hsetlik/ESP808_mk3/Schematic/Design/BoardImg.png

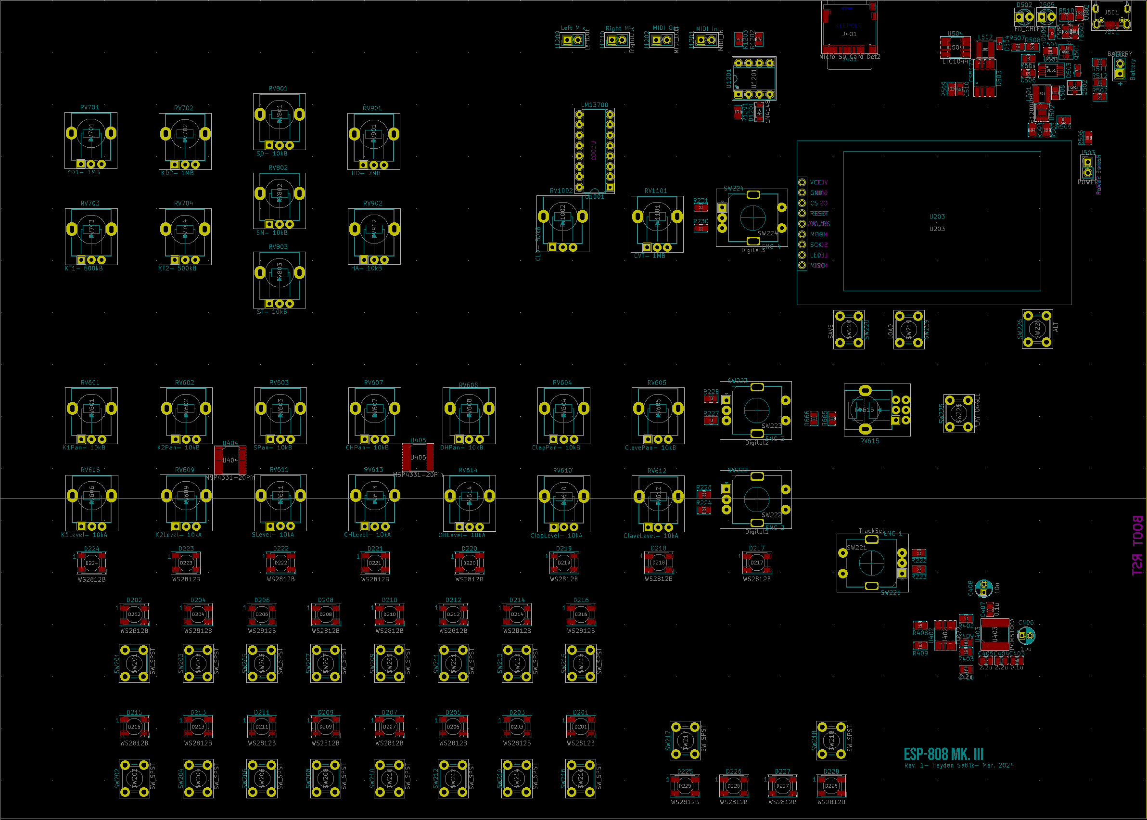
Schematic/Design/BoardImg.png
