hsetlik/ESP808_mk3/Schematic/Analog.kicad_sch

## KiCad design Schematic/Analog.kicad_sch (2024-04-10)

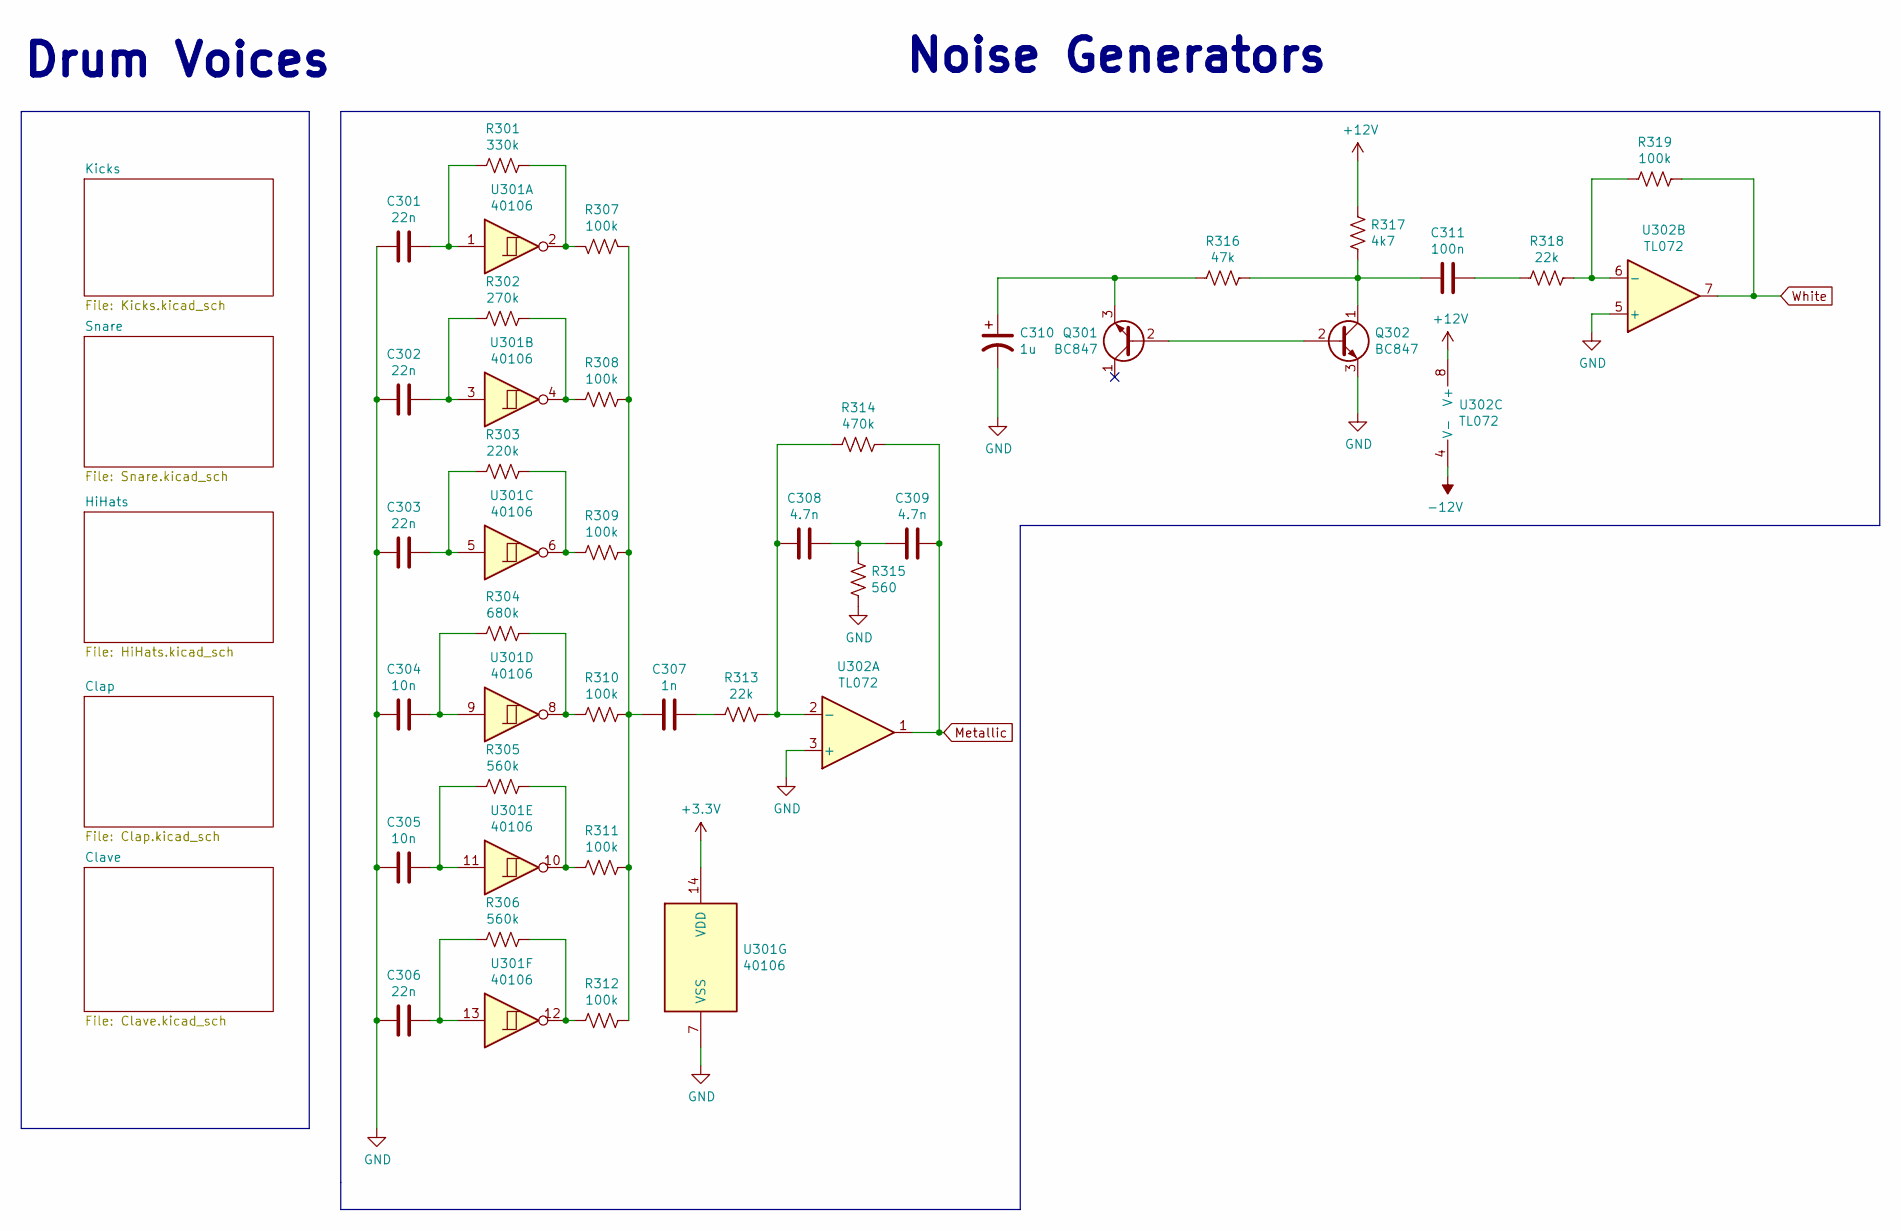
[picture p2: schematic Analog.kicad_sch]

Parts:
C301, C302, C303, C306: 22n; C_0805_2012Metric
C304, C305: 10n; C_0805_2012Metric
C307: 1n; C_0805_2012Metric
C308, C309: 4.7n; C_0805_2012Metric
C310: 1u; CP_Radial_D4.0mm_P2.00mm
C311: 100n; C_0805_2012Metric
Q301, Q302: BC847; SOT-23
R301: 330k; R_0805_2012Metric
R302: 270k; R_0805_2012Metric
R303: 220k; R_0805_2012Metric
R304: 680k; R_0805_2012Metric
R305, R306: 560k; R_0805_2012Metric
R307, R308, R309, R310, R311, R312, R319: 100k; R_0805_2012Metric
R313, R318: 22k; R_0805_2012Metric
R314: 470k; R_0805_2012Metric
R315: 560; R_0805_2012Metric
R316: 47k; R_0805_2012Metric
R317: 4k7; R_0805_2012Metric
U301: 40106; SOIC-14_3.9x8.7mm_P1.27mm
U302: TL072; SOIC-8_3.9x4.9mm_P1.27mm

Connections:
+3.3V: U301.14 (VDD)
+12V: R317.2, U302.8 (V+)
-12V: U302.4 (V-)
GND: C301.2, C302.2, C303.2, C304.2, C305.2, C306.2, C310.2, Q302.3 (E), R315.1, U301.7 (VSS), U302.3 (+), U302.5 (+)
Metallic: C309.1, R314.2, U302.1
unnamed: C301.1, R301.2, U301.1
unnamed: C302.1, R302.2, U301.3
unnamed: C303.1, R303.2, U301.5
unnamed: C304.1, R304.2, U301.9
unnamed: C305.1, R305.2, U301.11
unnamed: C306.1, R306.2, U301.13
unnamed: C307.1, R313.2
unnamed: C307.2, R307.1, R308.1, R309.1, R310.1, R311.1, R312.1
unnamed: C308.1, C309.2, R315.2
unnamed: C308.2, R313.1, R314.1, U302.2 (-)
unnamed: C310.1, Q301.3 (E), R316.2
unnamed: C311.1, R318.2
unnamed: C311.2, Q302.1 (C), R316.1, R317.1
unnamed: Q301.2 (B), Q302.2 (B)
unnamed: R301.1, R307.2, U301.2
unnamed: R302.1, R308.2, U301.4
unnamed: R303.1, R309.2, U301.6
unnamed: R304.1, R310.2, U301.8
unnamed: R305.1, R311.2, U301.10
unnamed: R306.1, R312.2, U301.12
unnamed: R318.1, R319.2, U302.6 (-)
White: R319.1, U302.7

Notes on the sheet:
Drum Voices
Noise Generators
