hsetlik/ESP808_mk3/Schematic/Clap.kicad_sch

## KiCad design Schematic/Clap.kicad_sch (2024-04-10)

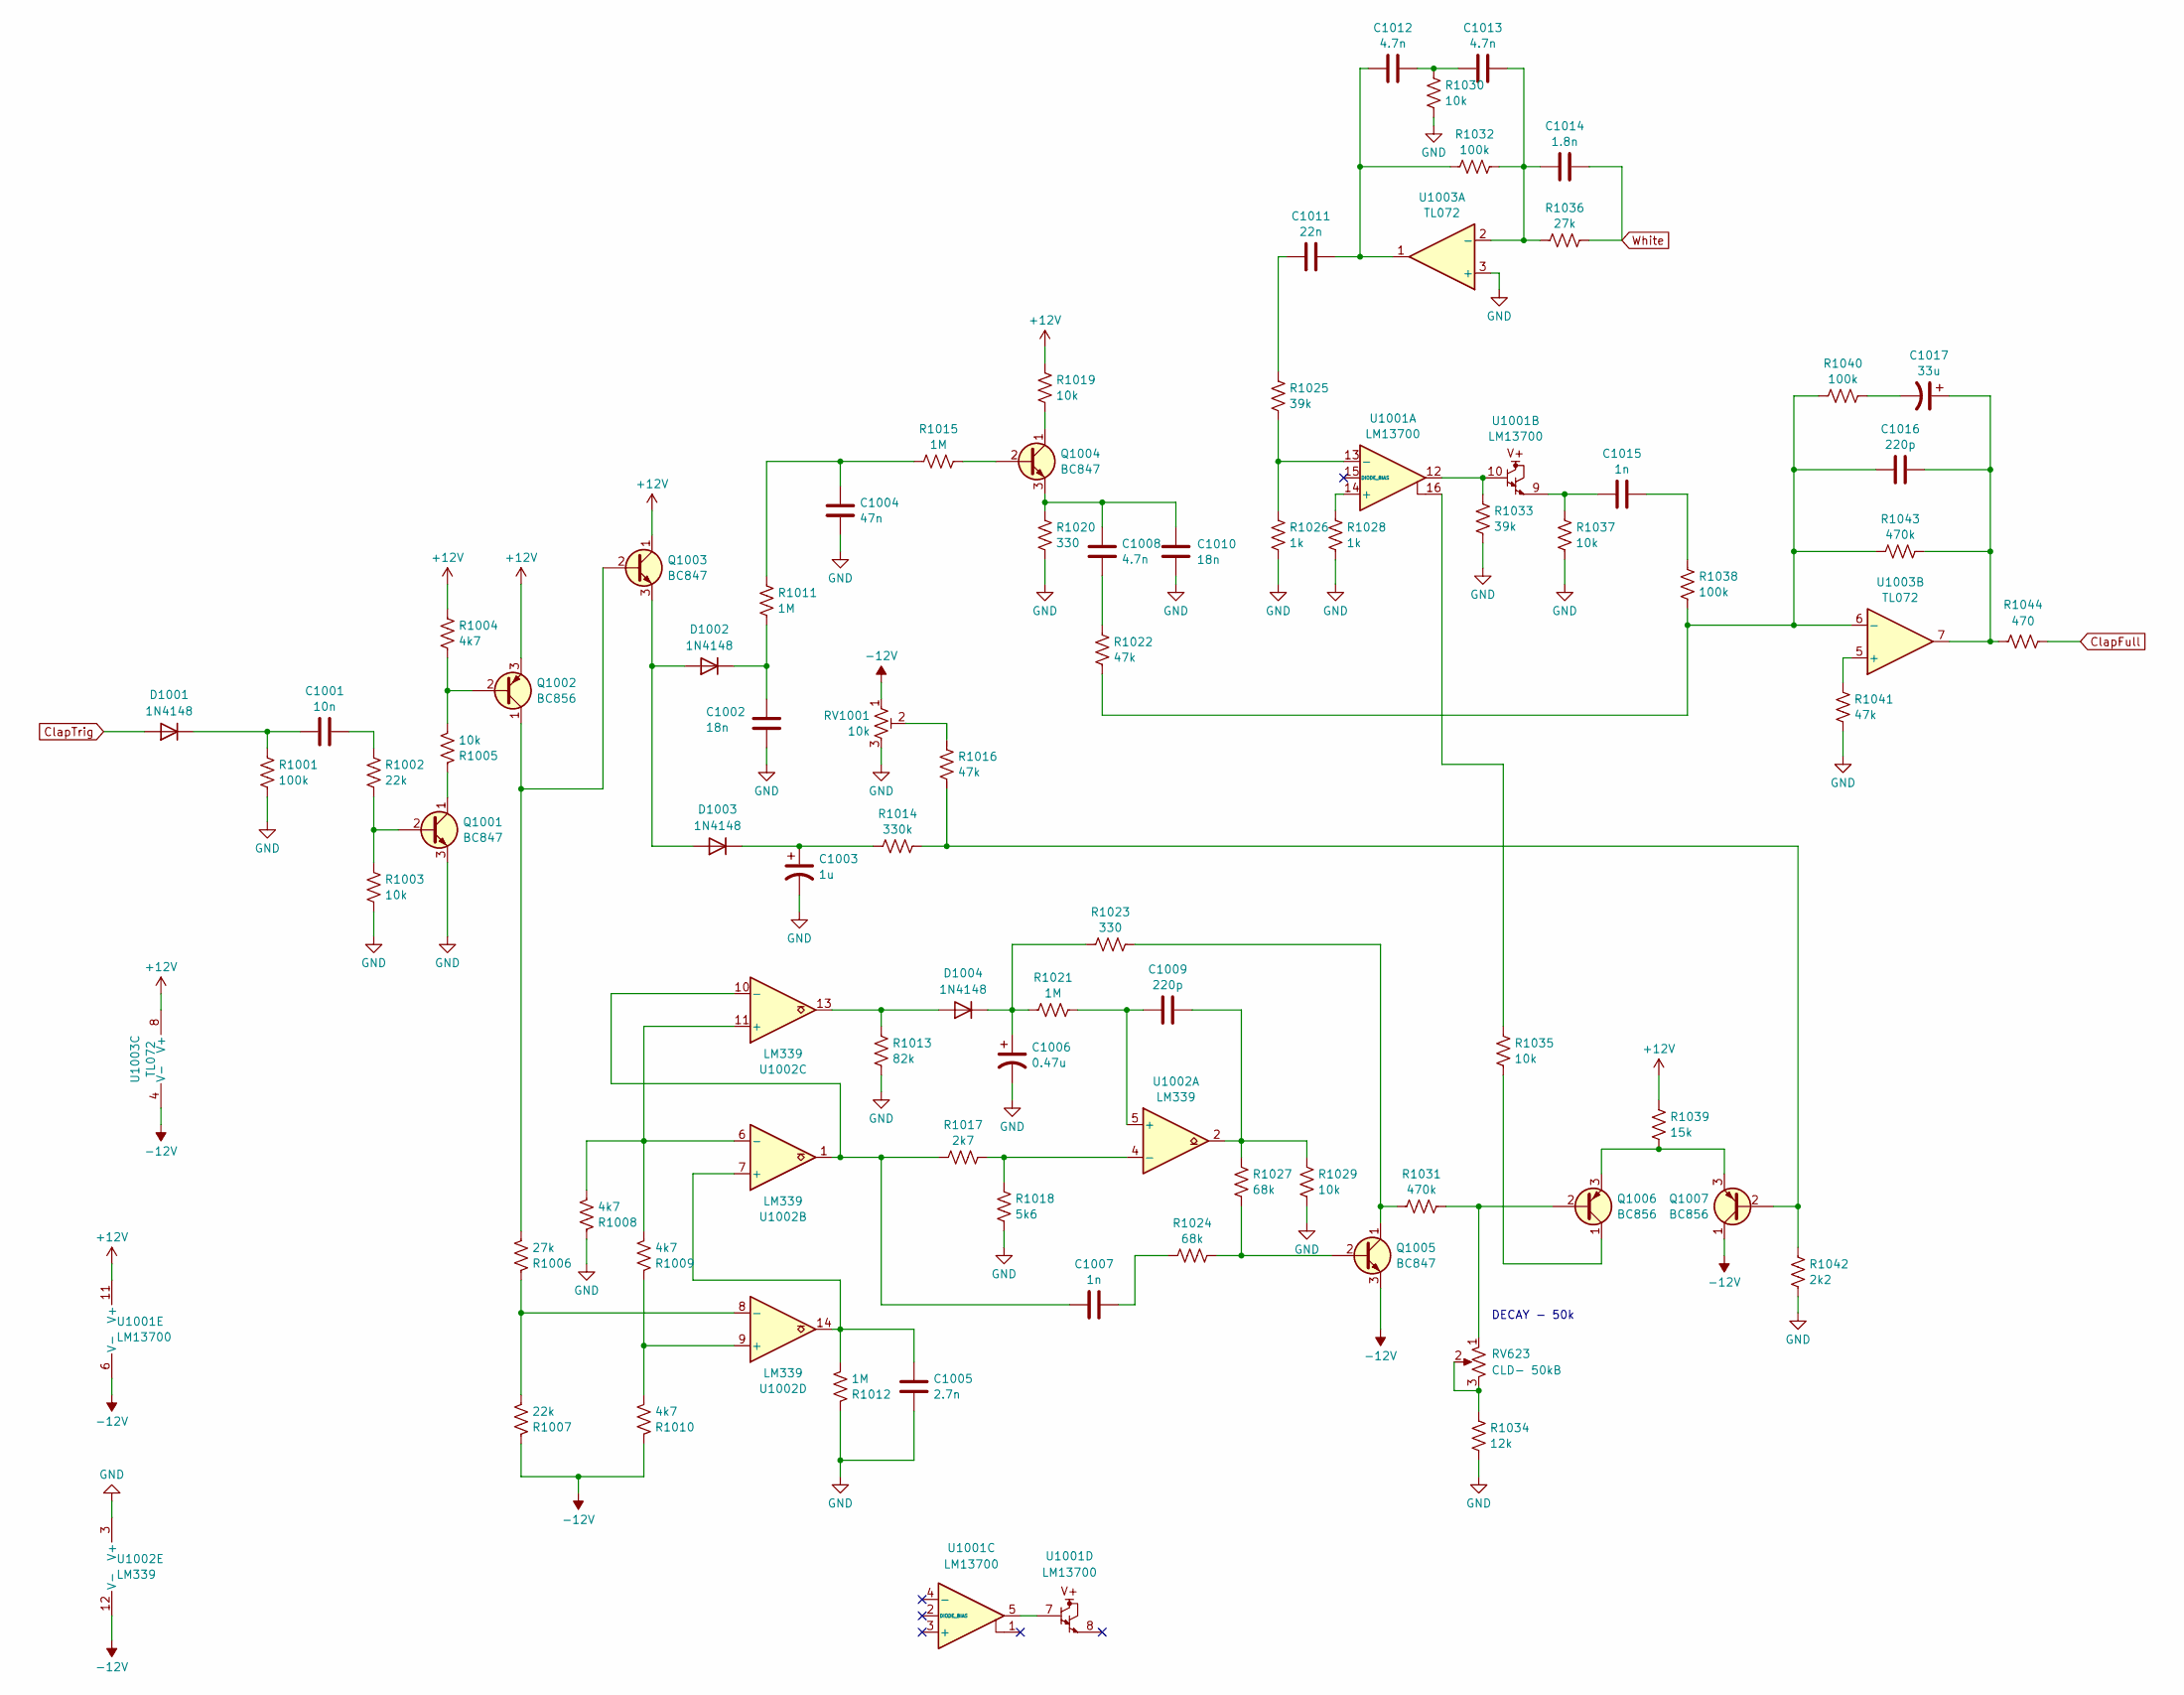
[picture p3: schematic Clap.kicad_sch]

Parts:
C1001: 10n; C_0805_2012Metric
C1002, C1010: 18n; C_0805_2012Metric
C1003: 1u; CP_Radial_D4.0mm_P2.00mm
C1004: 47n; C_0805_2012Metric
C1005: 2.7n; C_0805_2012Metric
C1006: 0.47u; C_0805_2012Metric
C1007, C1015: 1n; C_0805_2012Metric
C1008, C1012, C1013: 4.7n; C_0805_2012Metric
C1009, C1016: 220p; C_0805_2012Metric
C1011: 22n; C_0805_2012Metric
C1014: 1.8n; C_0805_2012Metric
C1017: 33u; CP_Radial_D5.0mm_P2.00mm
D1001, D1002, D1003, D1004: 1N4148; D_SOD-123
Q1001, Q1003, Q1004, Q1005: BC847; SOT-23
Q1002, Q1006, Q1007: BC856; SOT-23
R1001, R1032, R1038, R1040: 100k; R_0805_2012Metric
R1002, R1007: 22k; R_0805_2012Metric
R1003, R1005, R1019, R1029, R1030, R1035, R1037: 10k; R_0805_2012Metric
R1004, R1008, R1009, R1010: 4k7; R_0805_2012Metric
R1006, R1036: 27k; R_0805_2012Metric
R1011, R1012, R1015, R1021: 1M; R_0805_2012Metric
R1013: 82k; R_0805_2012Metric
R1014: 330k; R_0805_2012Metric
R1016, R1022, R1041: 47k; R_0805_2012Metric
R1017: 2k7; R_0805_2012Metric
R1018: 5k6; R_0805_2012Metric
R1020, R1023: 330; R_0805_2012Metric
R1024, R1027: 68k; R_0805_2012Metric
R1025, R1033: 39k; R_0805_2012Metric
R1026, R1028: 1k; R_0805_2012Metric
R1031, R1043: 470k; R_0805_2012Metric
R1034: 12k; R_0805_2012Metric
R1039: 15k; R_0805_2012Metric
R1042: 2k2; R_0805_2012Metric
R1044: 470; R_0805_2012Metric
RV623: CLD- 50kB; Potentiometer_Alpha_RD901F-40-00D_Single_Vertical
RV1001: 10k; Potentiometer_Piher_PT-6-V_Vertical
U1001: LM13700; DIP-16_W7.62mm
U1002: LM339; SOIC-14_3.9x8.7mm_P1.27mm
U1003: TL072; SOIC-8_3.9x4.9mm_P1.27mm

Connections:
+12V: Q1002.3 (E), Q1003.1 (C), R1004.1, R1019.1, R1039.2, U1001.11 (V+), U1003.8 (V+)
-12V: Q1005.3 (E), Q1007.1 (C), R1007.1, R1010.1, RV1001.1, U1001.6 (V-), U1002.12 (V-), U1003.4 (V-)
ClapFull: R1044.2
ClapTrig: D1001.2 (A)
GND: C1002.2, C1003.2, C1004.2, C1005.2, C1006.2, C1010.2, Q1001.3 (E), R1001.2, R1003.2, R1008.1, R1012.1, R1013.1, R1018.1, R1020.2, R1026.2, R1028.2, R1029.1, R1030.2, R1033.2, R1034.1, R1037.2, R1041.2, R1042.1, RV1001.3, U1002.3 (V+), U1003.3 (+)
unnamed: C1001.1, D1001.1 (K), R1001.1
unnamed: C1001.2, R1002.1
unnamed: C1002.1, D1002.1 (K), R1011.2
unnamed: C1003.1, D1003.1 (K), R1014.1
unnamed: C1004.1, R1011.1, R1015.1
unnamed: C1005.1, R1012.2, U1002.7 (+), U1002.14
unnamed: C1006.1, D1004.1 (K), R1021.2, R1023.2
unnamed: C1007.1, R1024.2
unnamed: C1007.2, R1017.1, U1002.1, U1002.10 (-)
unnamed: C1008.1, C1010.1, Q1004.3 (E), R1020.1
unnamed: C1008.2, R1022.1
unnamed: C1009.1, R1027.2, R1029.2, U1002.2
unnamed: C1009.2, R1021.1, U1002.5 (+)
unnamed: C1011.1, R1025.1
unnamed: C1011.2, C1012.1, R1032.1, U1003.1
unnamed: C1012.2, C1013.1, R1030.1
unnamed: C1013.2, C1014.1, R1032.2, R1036.1, U1003.2 (-)
unnamed: C1015.1, R1037.1, U1001.9
unnamed: C1015.2, R1038.1
unnamed: C1016.1, R1022.2, R1038.2, R1040.1, R1043.1, U1003.6 (-)
unnamed: C1016.2, C1017.1, R1043.2, R1044.1, U1003.7
unnamed: C1017.2, R1040.2
unnamed: D1002.2 (A), D1003.2 (A), Q1003.3 (E)
unnamed: D1004.2 (A), R1013.2, U1002.13
unnamed: Q1001.1 (C), R1005.1
unnamed: Q1001.2 (B), R1002.2, R1003.1
unnamed: Q1002.1 (C), Q1003.2 (B), R1006.2
unnamed: Q1002.2 (B), R1004.2, R1005.2
unnamed: Q1004.1 (C), R1019.2
unnamed: Q1004.2 (B), R1015.2
unnamed: Q1005.1 (C), R1023.1, R1031.2
unnamed: Q1005.2 (B), R1024.1, R1027.1
unnamed: Q1006.1 (C), R1035.2
unnamed: Q1006.2 (B), R1031.1, RV623.1
unnamed: Q1006.3 (E), Q1007.3 (E), R1039.1
unnamed: Q1007.2 (B), R1014.2, R1016.2, R1042.2
unnamed: R1006.1, R1007.2, U1002.8 (-)
unnamed: R1008.2, R1009.2, U1002.6 (-), U1002.11 (+)
unnamed: R1009.1, R1010.2, U1002.9 (+)
unnamed: R1016.1, RV1001.2
unnamed: R1017.2, R1018.2, U1002.4 (-)
unnamed: R1025.2, R1026.1, U1001.13 (-)
unnamed: R1028.1, U1001.14 (+)
unnamed: R1033.1, U1001.10, U1001.12
unnamed: R1034.2, RV623.2, RV623.3
unnamed: R1035.1, U1001.16
unnamed: R1041.1, U1003.5 (+)
unnamed: U1001.5, U1001.7
White: C1014.2, R1036.2

Notes on the sheet:
DECAY - 50k
