hsetlik/ESP808_mk3/Schematic/Clave.kicad_sch

## KiCad design Schematic/Clave.kicad_sch (2024-04-11)

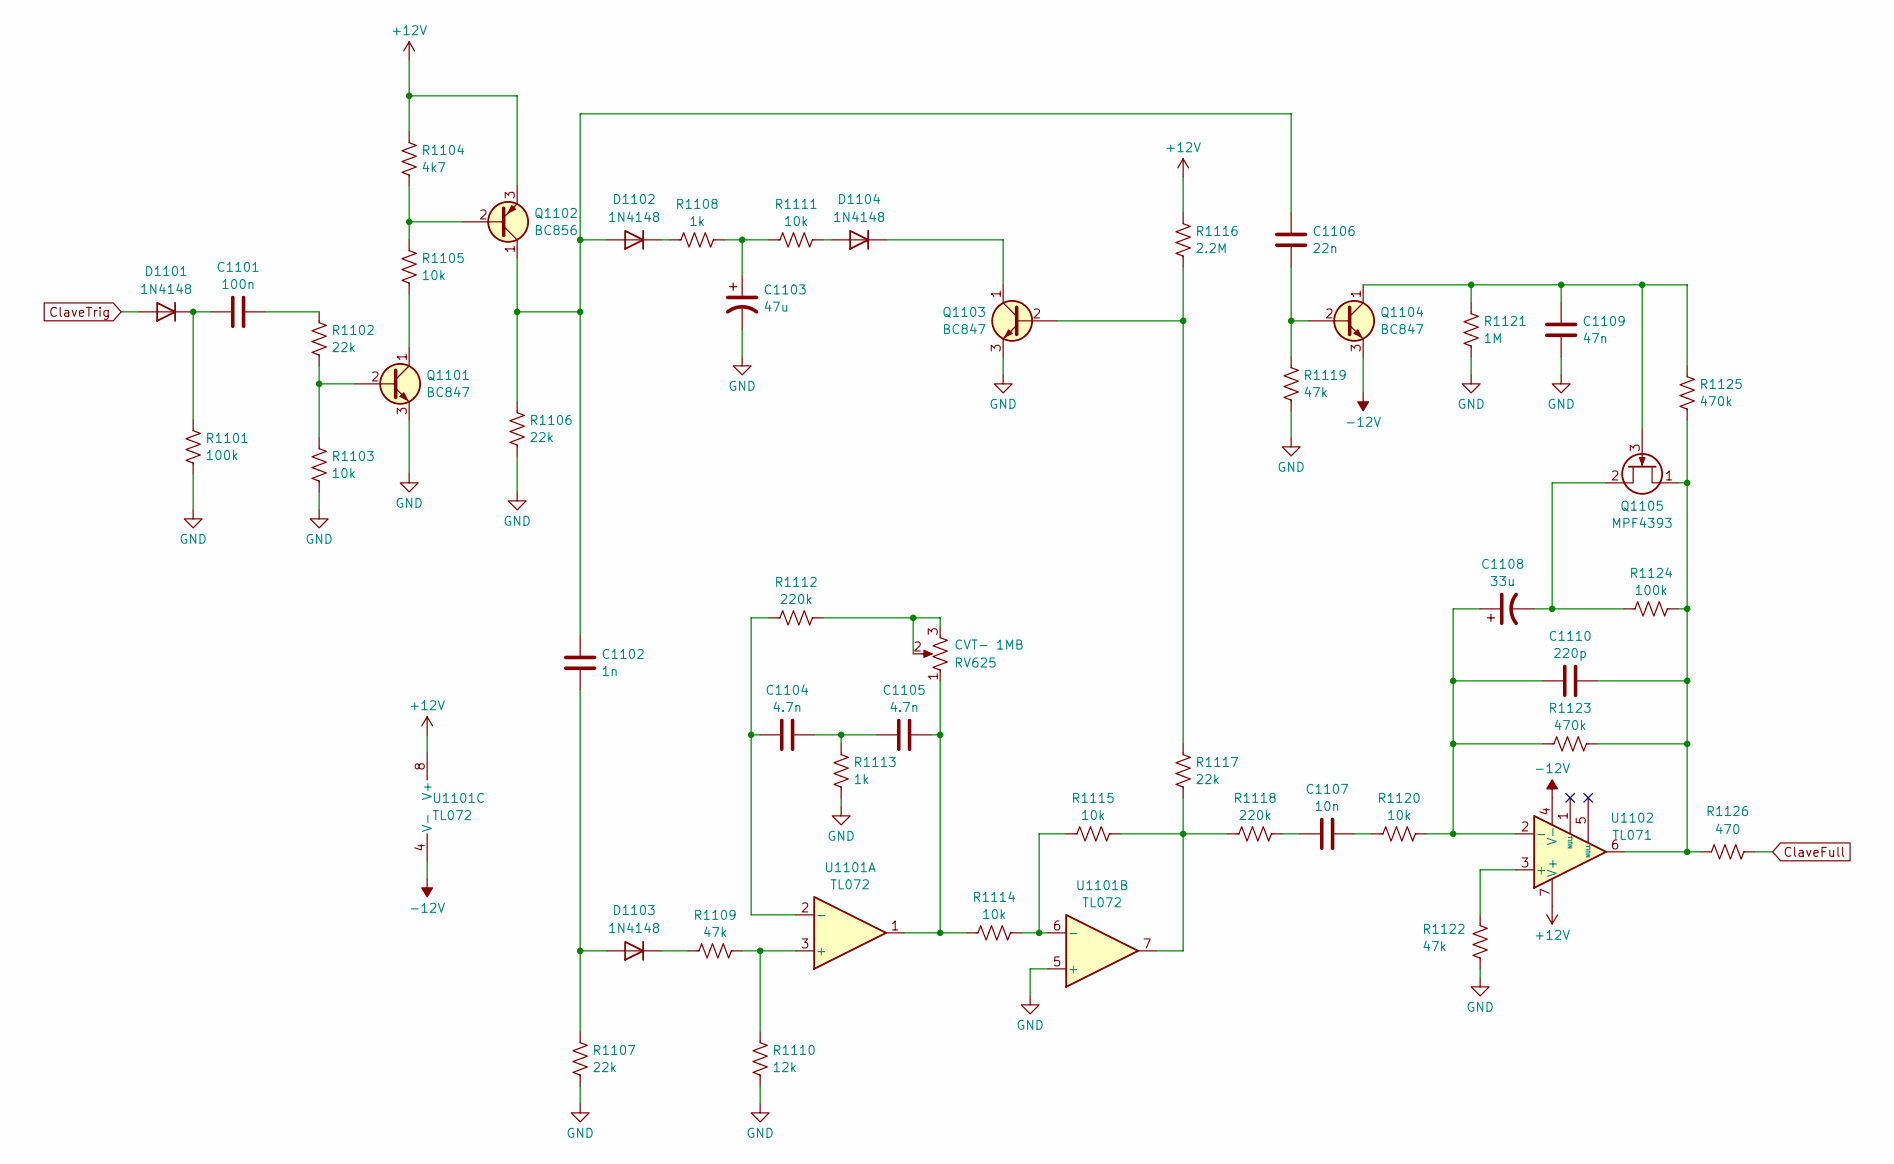
[picture p4: schematic Clave.kicad_sch]

Parts:
C1101: 100n; C_0805_2012Metric
C1102: 1n; C_0805_2012Metric
C1103: 47u; CP_Radial_D5.0mm_P2.00mm
C1104, C1105: 4.7n; C_0805_2012Metric
C1106: 22n; C_0805_2012Metric
C1107: 10n; C_0805_2012Metric
C1108: 33u; CP_Radial_D5.0mm_P2.00mm
C1109: 47n; C_0805_2012Metric
C1110: 220p; C_0805_2012Metric
D1101, D1102, D1103, D1104: 1N4148; D_SOD-123
Q1101, Q1103, Q1104: BC847; SOT-23
Q1102: BC856; SOT-23
Q1105: MPF4393; TO-92L
R1101, R1124: 100k; R_0805_2012Metric
R1102, R1106, R1107, R1117: 22k; R_0805_2012Metric
R1103, R1105, R1111, R1114, R1115, R1120: 10k; R_0805_2012Metric
R1104: 4k7; R_0805_2012Metric
R1108, R1113: 1k; R_0805_2012Metric
R1109, R1119, R1122: 47k; R_0805_2012Metric
R1110: 12k; R_0805_2012Metric
R1112, R1118: 220k; R_0805_2012Metric
R1116: 2.2M; R_0805_2012Metric
R1121: 1M; R_0805_2012Metric
R1123, R1125: 470k; R_0805_2012Metric
R1126: 470; R_0805_2012Metric
RV625: CVT- 1MB; Potentiometer_Alpha_RD901F-40-00D_Single_Vertical
U1101: TL072; SOIC-8_3.9x4.9mm_P1.27mm
U1102: TL071; SOIC-8_3.9x4.9mm_P1.27mm

Connections:
+12V: Q1102.3 (E), R1104.1, R1116.2, U1101.8 (V+), U1102.7 (V+)
-12V: Q1104.3 (E), U1101.4 (V-), U1102.4 (V-)
ClaveFull: R1126.2
ClaveTrig: D1101.2 (A)
GND: C1103.2, C1109.2, Q1101.3 (E), Q1103.3 (E), R1101.2, R1103.2, R1106.2, R1107.1, R1110.1, R1113.2, R1119.1, R1121.2, R1122.1, U1101.5 (+)
unnamed: C1101.1, D1101.1 (K), R1101.1
unnamed: C1101.2, R1102.1
unnamed: C1102.1, C1106.1, D1102.2 (A), Q1102.1 (C), R1106.1
unnamed: C1102.2, D1103.2 (A), R1107.2
unnamed: C1103.1, R1108.2, R1111.1
unnamed: C1104.1, R1112.1, U1101.2 (-)
unnamed: C1104.2, C1105.1, R1113.1
unnamed: C1105.2, R1114.1, RV625.1, U1101.1
unnamed: C1106.2, Q1104.2 (B), R1119.2
unnamed: C1107.1, R1118.2
unnamed: C1107.2, R1120.1
unnamed: C1108.1, C1110.1, R1120.2, R1123.1, U1102.2 (-)
unnamed: C1108.2, Q1105.2 (S), R1124.1
unnamed: C1109.1, Q1104.1 (C), Q1105.3 (G), R1121.1, R1125.1
unnamed: C1110.2, Q1105.1 (D), R1123.2, R1124.2, R1125.2, R1126.1, U1102.6
unnamed: D1102.1 (K), R1108.1
unnamed: D1103.1 (K), R1109.2
unnamed: D1104.1 (K), Q1103.1 (C)
unnamed: D1104.2 (A), R1111.2
unnamed: Q1101.1 (C), R1105.2
unnamed: Q1101.2 (B), R1102.2, R1103.1
unnamed: Q1102.2 (B), R1104.2, R1105.1
unnamed: Q1103.2 (B), R1116.1, R1117.2
unnamed: R1109.1, R1110.2, U1101.3 (+)
unnamed: R1112.2, RV625.2, RV625.3
unnamed: R1114.2, R1115.1, U1101.6 (-)
unnamed: R1115.2, R1117.1, R1118.1, U1101.7
unnamed: R1122.2, U1102.3 (+)
