hsetlik/ESP808_mk3/Schematic/Controls.kicad_sch

## KiCad design Schematic/Controls.kicad_sch (2024-04-14)

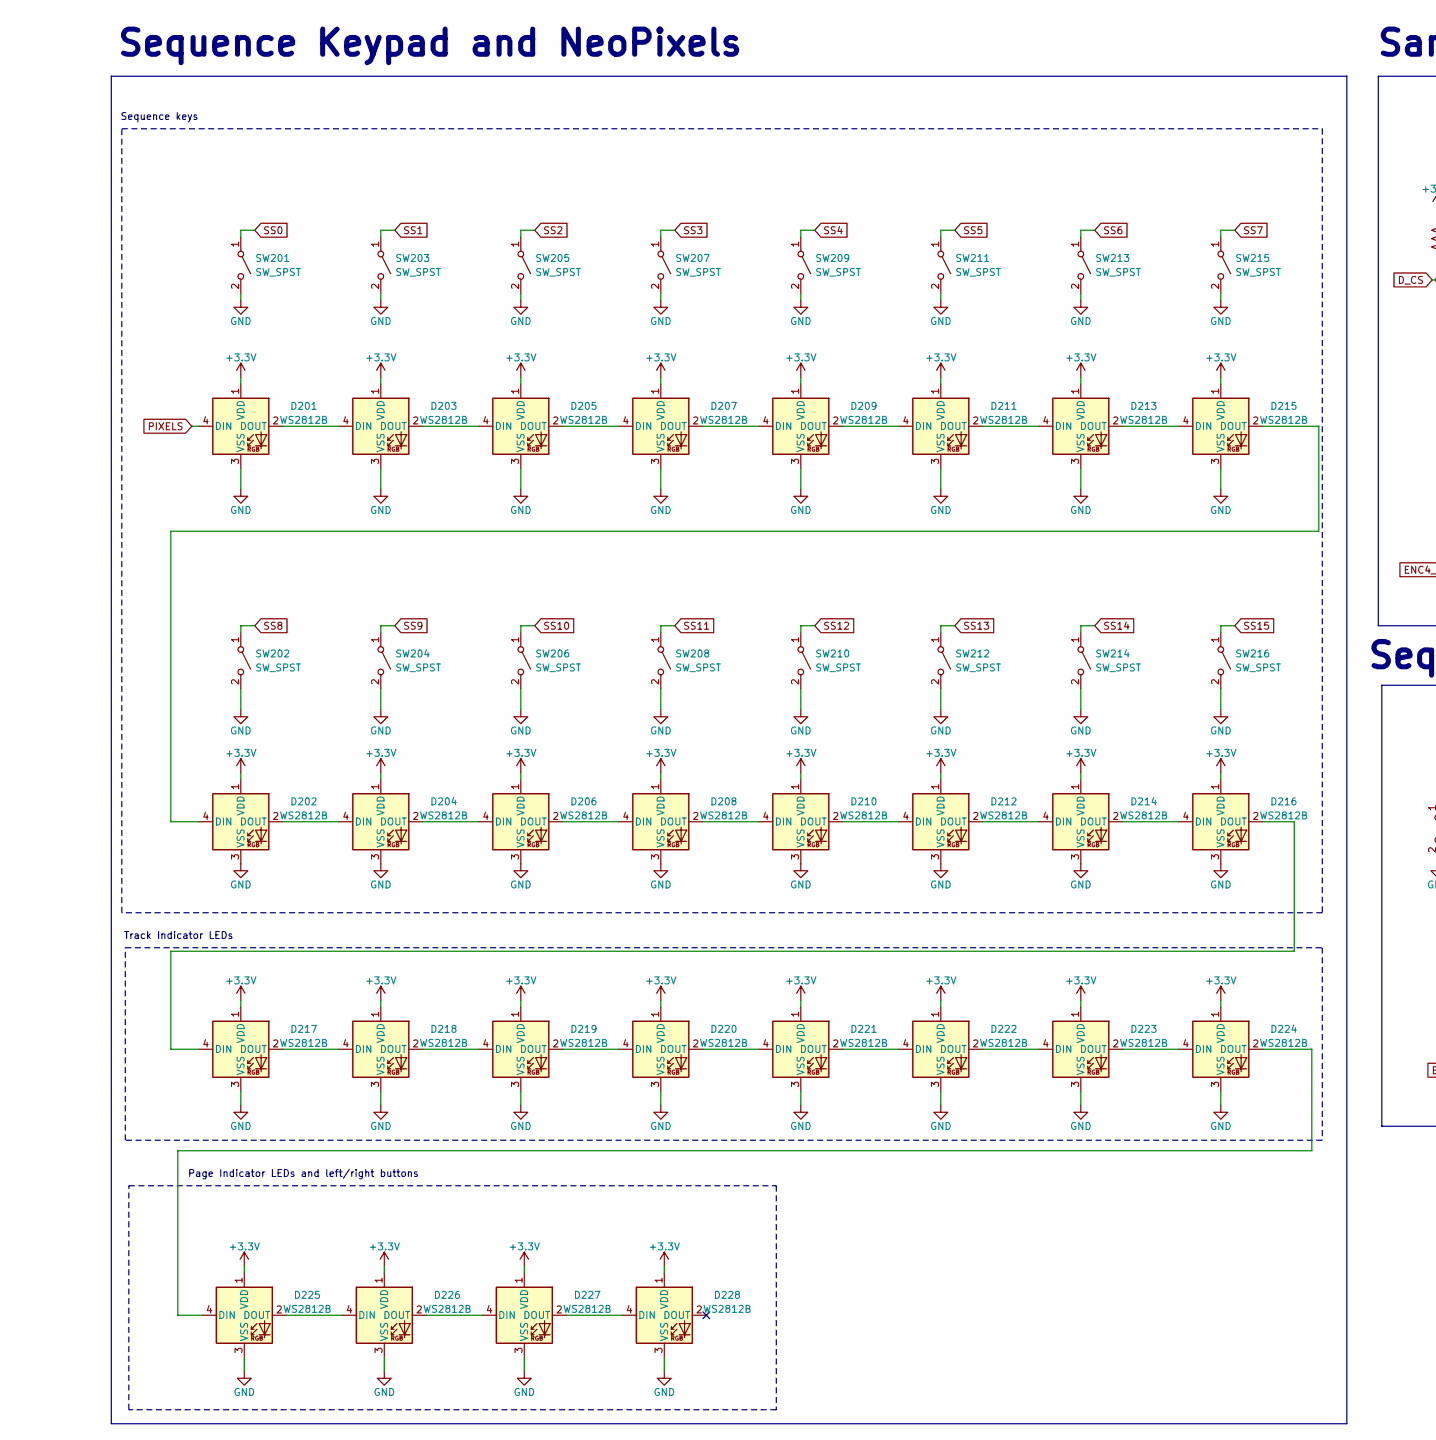
[picture p5: schematic Controls.kicad_sch, part in row 1, column 1]

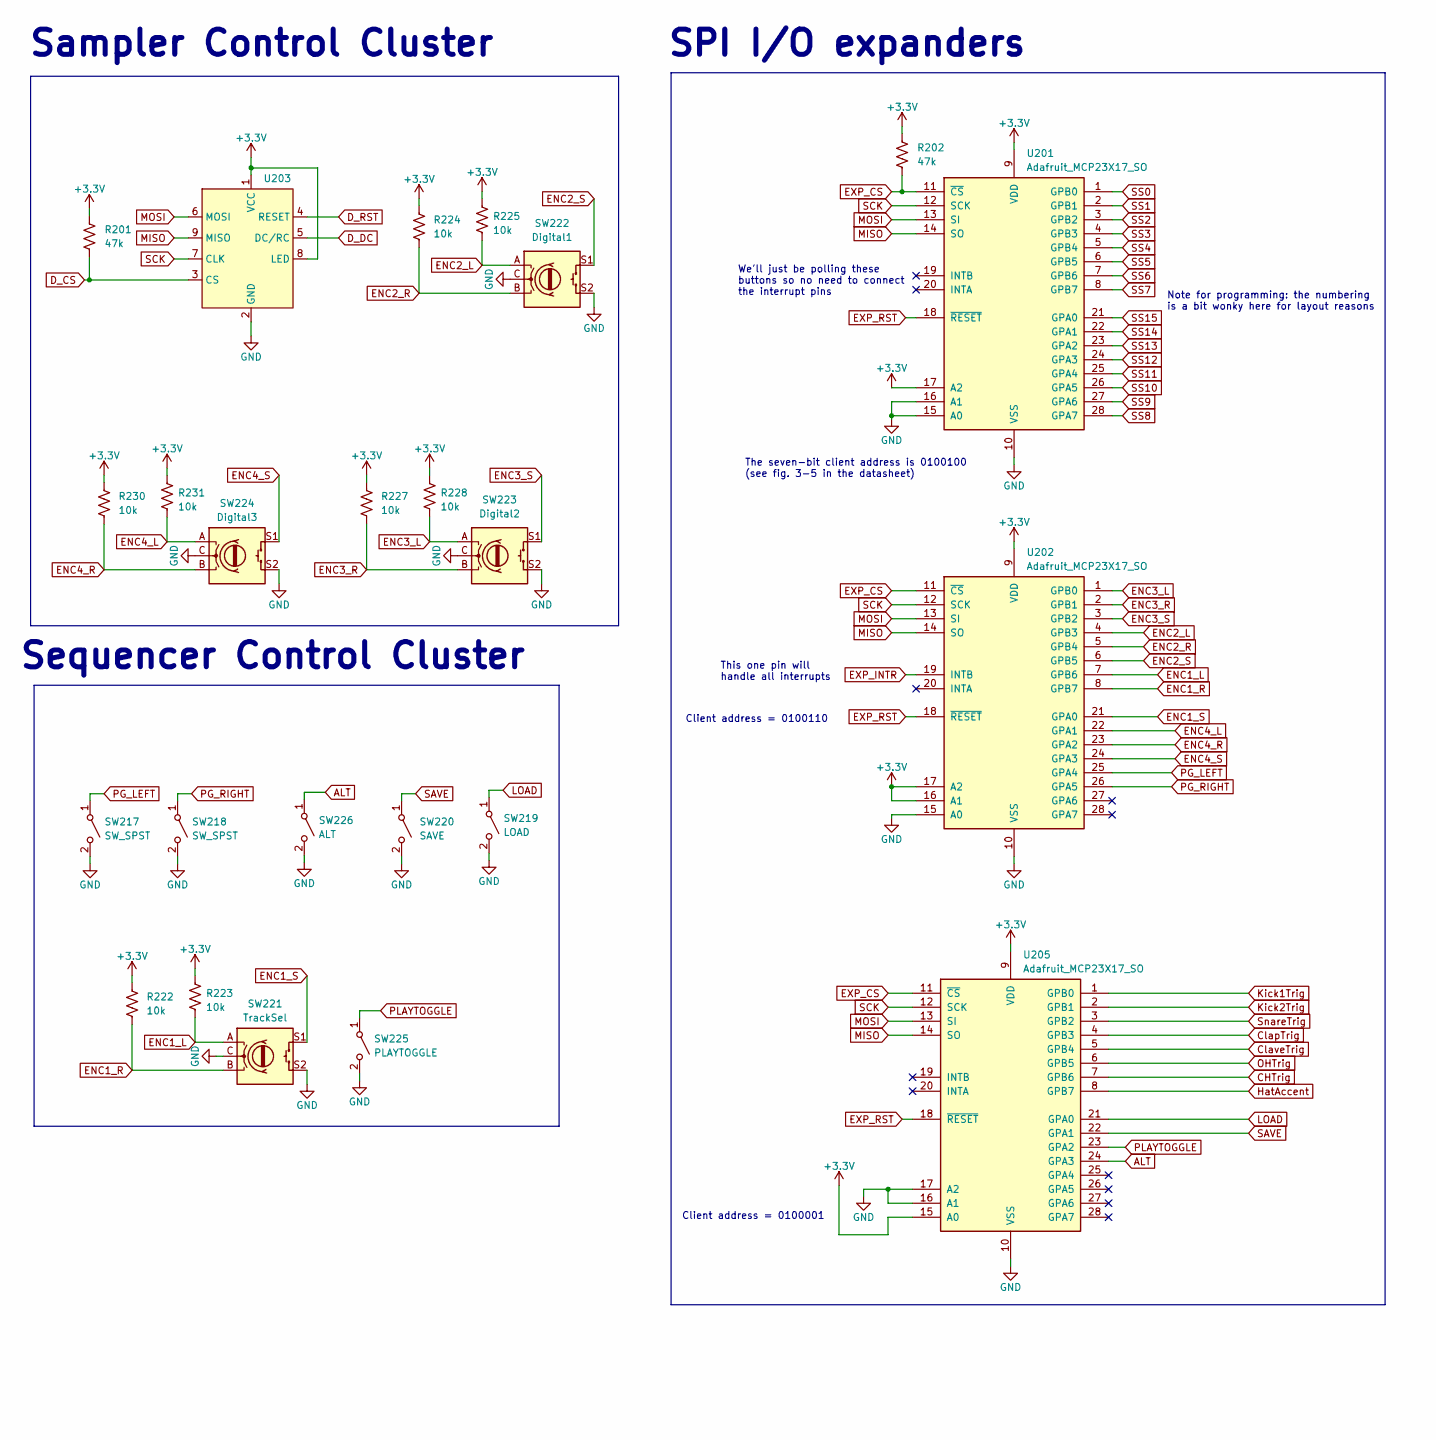
[picture p6: schematic Controls.kicad_sch, part in row 1, column 2]

Parts:
D201, D202, D203, D204, D205, D206, D207, D208, D209, D210, D211, D212, D213, D214, D215, D216, D217, D218, D219, D220, D221, D222, D223, D224, D225, D226, D227, D228: WS2812B; LED_WS2812B_PLCC4_5.0x5.0mm_P3.2mm
R201, R202: 47k; R_0805_2012Metric
R222, R223, R224, R225, R227, R228, R230, R231: 10k; R_0805_2012Metric
SW201, SW202, SW203, SW204, SW205, SW206, SW207, SW208, SW209, SW210, SW211, SW212, SW213, SW214, SW215, SW216, SW217, SW218: SW_SPST; SW_PUSH_6mm
SW219: LOAD; SW_PUSH_6mm
SW220: SAVE; SW_PUSH_6mm
SW221: TrackSel; RotaryEncoder_Alps_EC11E-Switch_Vertical_H20mm_5Pin
SW222: Digital1; RotaryEncoder_Alps_EC11E-Switch_Vertical_H20mm_5Pin
SW223: Digital2; RotaryEncoder_Alps_EC11E-Switch_Vertical_H20mm_5Pin
SW224: Digital3; RotaryEncoder_Alps_EC11E-Switch_Vertical_H20mm_5Pin
SW225: PLAYTOGGLE; SW_PUSH_6mm
SW226: ALT; SW_PUSH_6mm
U201, U202, U205: Adafruit_MCP23X17_SO; SOIC-28W_7.5x17.9mm_P1.27mm
U203: TFTBreakout_ILI9341_340x320

Connections:
+3.3V: D201.1 (VDD), D202.1 (VDD), D203.1 (VDD), D204.1 (VDD), D205.1 (VDD), D206.1 (VDD), D207.1 (VDD), D208.1 (VDD), D209.1 (VDD), D210.1 (VDD), D211.1 (VDD), D212.1 (VDD), D213.1 (VDD), D214.1 (VDD), D215.1 (VDD), D216.1 (VDD), D217.1 (VDD), D218.1 (VDD), D219.1 (VDD), D220.1 (VDD), D221.1 (VDD), D222.1 (VDD), D223.1 (VDD), D224.1 (VDD), D225.1 (VDD), D226.1 (VDD), D227.1 (VDD), D228.1 (VDD), R201.1, R202.1, R222.1, R223.1, R224.1, R225.1, R227.1, R228.1, R230.1, R231.1, U201.9 (VDD), U201.17 (A2), U202.9 (VDD), U202.16 (A1), U202.17 (A2), U203.1 (VCC), U203.8 (LED), U205.9 (VDD), U205.15 (A0)
ALT: SW226.1 (A), U205.24 (GPA3)
CHTrig: U205.7 (GPB6)
ClapTrig: U205.4 (GPB3)
ClaveTrig: U205.5 (GPB4)
D_CS: R201.2, U203.3 (CS)
D_DC: U203.5 (DC/RC)
D_RST: U203.4 (RESET)
ENC1_L: R223.2, SW221.A, U202.7 (GPB6)
ENC1_R: R222.2, SW221.B, U202.8 (GPB7)
ENC1_S: SW221.S1, U202.21 (GPA0)
ENC2_L: R225.2, SW222.A, U202.4 (GPB3)
ENC2_R: R224.2, SW222.B, U202.5 (GPB4)
ENC2_S: SW222.S1, U202.6 (GPB5)
ENC3_L: R228.2, SW223.A, U202.1 (GPB0)
ENC3_R: R227.2, SW223.B, U202.2 (GPB1)
ENC3_S: SW223.S1, U202.3 (GPB2)
ENC4_L: R231.2, SW224.A, U202.22 (GPA1)
ENC4_R: R230.2, SW224.B, U202.23 (GPA2)
ENC4_S: SW224.S1, U202.24 (GPA3)
EXP_CS: R202.2, U201.11 (~CS), U202.11 (~CS), U205.11 (~CS)
EXP_INTR: U202.19 (INTB)
EXP_RST: U201.18 (~RESET), U202.18 (~RESET), U205.18 (~RESET)
GND: D201.3 (VSS), D202.3 (VSS), D203.3 (VSS), D204.3 (VSS), D205.3 (VSS), D206.3 (VSS), D207.3 (VSS), D208.3 (VSS), D209.3 (VSS), D210.3 (VSS), D211.3 (VSS), D212.3 (VSS), D213.3 (VSS), D214.3 (VSS), D215.3 (VSS), D216.3 (VSS), D217.3 (VSS), D218.3 (VSS), D219.3 (VSS), D220.3 (VSS), D221.3 (VSS), D222.3 (VSS), D223.3 (VSS), D224.3 (VSS), D225.3 (VSS), D226.3 (VSS), D227.3 (VSS), D228.3 (VSS), SW201.2 (B), SW202.2 (B), SW203.2 (B), SW204.2 (B), SW205.2 (B), SW206.2 (B), SW207.2 (B), SW208.2 (B), SW209.2 (B), SW210.2 (B), SW211.2 (B), SW212.2 (B), SW213.2 (B), SW214.2 (B), SW215.2 (B), SW216.2 (B), SW217.2 (B), SW218.2 (B), SW219.2 (B), SW220.2 (B), SW221.C, SW221.S2, SW222.C, SW222.S2, SW223.C, SW223.S2, SW224.C, SW224.S2, SW225.2 (B), SW226.2 (B), U201.10 (VSS), U201.15 (A0), U201.16 (A1), U202.10 (VSS), U202.15 (A0), U203.2 (GND), U205.10 (VSS), U205.16 (A1), U205.17 (A2)
HatAccent: U205.8 (GPB7)
Kick1Trig: U205.1 (GPB0)
Kick2Trig: U205.2 (GPB1)
LOAD: SW219.1 (A), U205.21 (GPA0)
MISO: U201.14 (SO), U202.14 (SO), U203.9 (MISO), U205.14 (SO)
MOSI: U201.13 (SI), U202.13 (SI), U203.6 (MOSI), U205.13 (SI)
unnamed: D201.2 (DOUT), D203.4 (DIN)
unnamed: D202.2 (DOUT), D204.4 (DIN)
unnamed: D202.4 (DIN), D215.2 (DOUT)
unnamed: D203.2 (DOUT), D205.4 (DIN)
unnamed: D204.2 (DOUT), D206.4 (DIN)
unnamed: D205.2 (DOUT), D207.4 (DIN)
unnamed: D206.2 (DOUT), D208.4 (DIN)
unnamed: D207.2 (DOUT), D209.4 (DIN)
unnamed: D208.2 (DOUT), D210.4 (DIN)
unnamed: D209.2 (DOUT), D211.4 (DIN)
unnamed: D210.2 (DOUT), D212.4 (DIN)
unnamed: D211.2 (DOUT), D213.4 (DIN)
unnamed: D212.2 (DOUT), D214.4 (DIN)
unnamed: D213.2 (DOUT), D215.4 (DIN)
unnamed: D214.2 (DOUT), D216.4 (DIN)
unnamed: D216.2 (DOUT), D217.4 (DIN)
unnamed: D217.2 (DOUT), D218.4 (DIN)
unnamed: D218.2 (DOUT), D219.4 (DIN)
unnamed: D219.2 (DOUT), D220.4 (DIN)
unnamed: D220.2 (DOUT), D221.4 (DIN)
unnamed: D221.2 (DOUT), D222.4 (DIN)
unnamed: D222.2 (DOUT), D223.4 (DIN)
unnamed: D223.2 (DOUT), D224.4 (DIN)
unnamed: D224.2 (DOUT), D225.4 (DIN)
unnamed: D225.2 (DOUT), D226.4 (DIN)
unnamed: D226.2 (DOUT), D227.4 (DIN)
unnamed: D227.2 (DOUT), D228.4 (DIN)
OHTrig: U205.6 (GPB5)
PG_LEFT: SW217.1 (A), U202.25 (GPA4)
PG_RIGHT: SW218.1 (A), U202.26 (GPA5)
PIXELS: D201.4 (DIN)
PLAYTOGGLE: SW225.1 (A), U205.23 (GPA2)
SAVE: SW220.1 (A), U205.22 (GPA1)
SCK: U201.12 (SCK), U202.12 (SCK), U203.7 (CLK), U205.12 (SCK)
SS0: SW201.1 (A), U201.1 (GPB0)
SS1: SW203.1 (A), U201.2 (GPB1)
SS2: SW205.1 (A), U201.3 (GPB2)
SS3: SW207.1 (A), U201.4 (GPB3)
SS4: SW209.1 (A), U201.5 (GPB4)
SS5: SW211.1 (A), U201.6 (GPB5)
SS6: SW213.1 (A), U201.7 (GPB6)
SS7: SW215.1 (A), U201.8 (GPB7)
SS8: SW202.1 (A), U201.28 (GPA7)
SS9: SW204.1 (A), U201.27 (GPA6)
SS10: SW206.1 (A), U201.26 (GPA5)
SS11: SW208.1 (A), U201.25 (GPA4)
SS12: SW210.1 (A), U201.24 (GPA3)
SS13: SW212.1 (A), U201.23 (GPA2)
SS14: SW214.1 (A), U201.22 (GPA1)
SS15: SW216.1 (A), U201.21 (GPA0)
SnareTrig: U205.3 (GPB2)

Notes on the sheet:
Sequencer Control Cluster
Client address = 0100001
Sampler Control Cluster
This one pin will handle all interrupts
Sequence Keypad and NeoPixels
SPI I/O expanders
Sequence keys
Page Indicator LEDs and left/right buttons
We'll just be polling these buttons so no need to connect the interrupt pins
Track Indicator LEDs
Note for programming: the numbering is a bit wonky here for layout reasons
Client address = 0100110
The seven-bit client address is 0100100 (see fig. 3-5 in the datasheet)
