hsetlik/ESP808_mk3/Schematic/HiHats.kicad_sch

## KiCad design Schematic/HiHats.kicad_sch (2024-04-10)

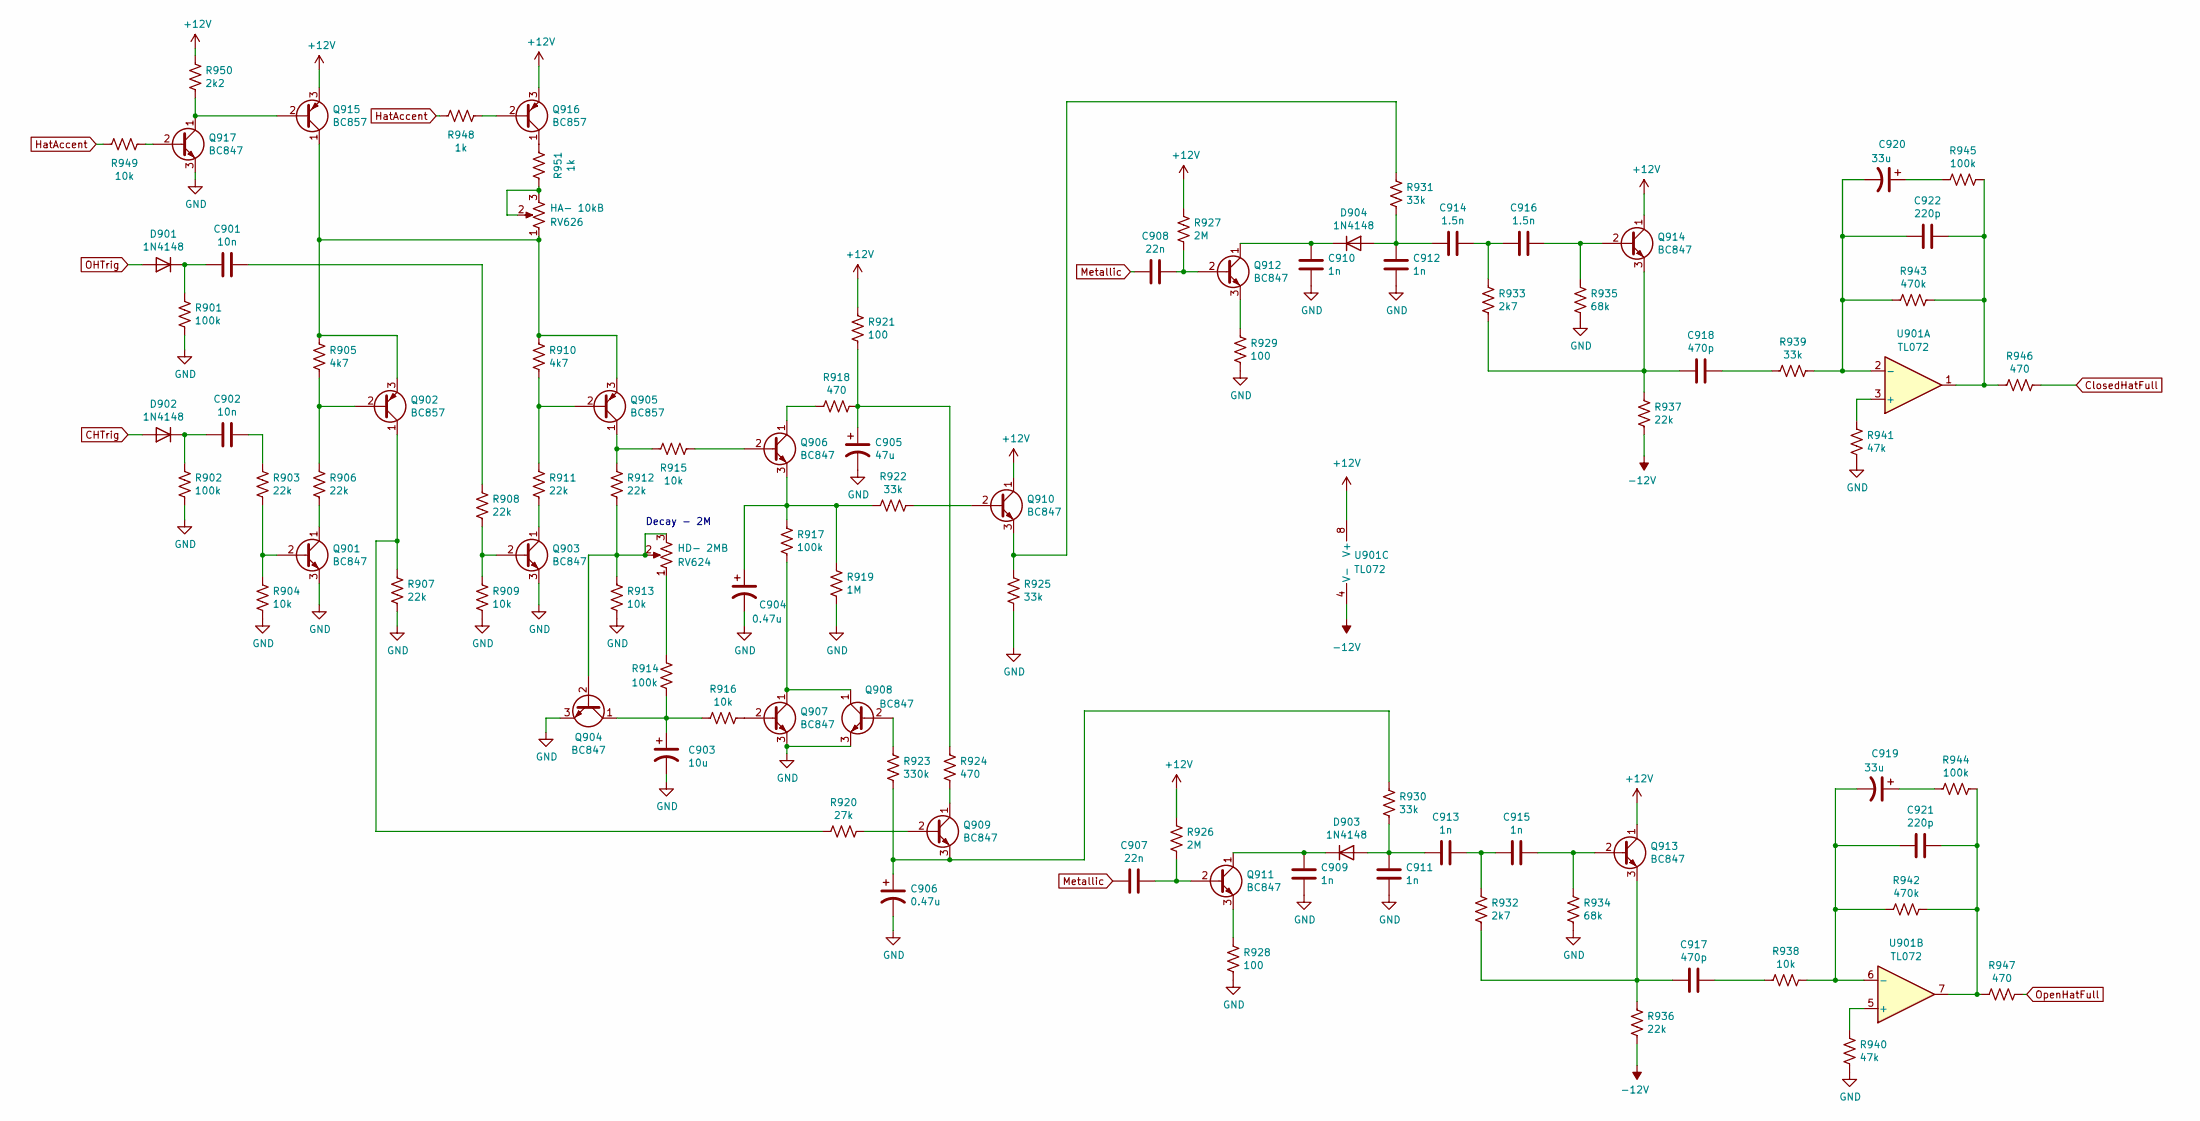
[picture p7: schematic HiHats.kicad_sch]

Parts:
C901, C902: 10n; C_0805_2012Metric
C903: 10u; CP_Radial_D4.0mm_P2.00mm
C904, C906: 0.47u; CP_Radial_D4.0mm_P2.00mm
C905: 47u; CP_Radial_D4.0mm_P2.00mm
C907, C908: 22n; C_0805_2012Metric
C909, C910, C911, C912, C913, C915: 1n; C_0805_2012Metric
C914, C916: 1.5n; C_0805_2012Metric
C917, C918: 470p; C_0805_2012Metric
C919, C920: 33u; CP_Radial_D5.0mm_P2.00mm
C921, C922: 220p; C_0805_2012Metric
D901, D902, D903, D904: 1N4148; D_SOD-123
Q901, Q903, Q904, Q906, Q907, Q908, Q909, Q910, Q911, Q912, Q913, Q914, Q917: BC847; SOT-23
Q902, Q905, Q915, Q916: BC857; SOT-23
R901, R902, R914, R917, R944, R945: 100k; R_0805_2012Metric
R903, R906, R907, R908, R911, R912, R936, R937: 22k; R_0805_2012Metric
R904, R909, R913, R915, R916, R938, R949: 10k; R_0805_2012Metric
R905, R910: 4k7; R_0805_2012Metric
R918, R924, R946, R947: 470; R_0805_2012Metric
R919: 1M; R_0805_2012Metric
R920: 27k; R_0805_2012Metric
R921, R928, R929: 100; R_0805_2012Metric
R922, R925, R930, R931, R939: 33k; R_0805_2012Metric
R923: 330k; R_0805_2012Metric
R926, R927: 2M; R_0805_2012Metric
R932, R933: 2k7; R_0805_2012Metric
R934, R935: 68k; R_0805_2012Metric
R940, R941: 47k; R_0805_2012Metric
R942, R943: 470k; R_0805_2012Metric
R948, R951: 1k; R_0805_2012Metric
R950: 2k2; R_0805_2012Metric
RV624: HD- 2MB; Potentiometer_Alpha_RD901F-40-00D_Single_Vertical
RV626: HA- 10kB; Potentiometer_Alpha_RD901F-40-00D_Single_Vertical
U901: TL072; SOIC-8_3.9x4.9mm_P1.27mm

Connections:
+12V: Q910.1 (C), Q913.1 (C), Q914.1 (C), Q915.3 (E), Q916.3 (E), R921.2, R926.1, R927.1, R950.1, U901.8 (V+)
-12V: R936.2, R937.2, U901.4 (V-)
CHTrig: D902.2 (A)
ClosedHatFull: R946.1
GND: C903.2, C904.2, C905.2, C906.2, C909.1, C910.1, C911.1, C912.1, Q901.3 (E), Q903.3 (E), Q904.3 (E), Q907.3 (E), Q908.3 (E), Q917.3 (E), R901.2, R902.2, R904.2, R907.2, R909.2, R913.2, R919.2, R925.1, R928.2, R929.2, R934.2, R935.2, R940.1, R941.1
HatAccent: R948.2, R949.2
Metallic: C907.2, C908.2
unnamed: C901.1, R908.1
unnamed: C901.2, D901.1 (K), R901.1
unnamed: C902.1, R903.1
unnamed: C902.2, D902.1 (K), R902.1
unnamed: C903.1, Q904.1 (C), R914.2, R916.2
unnamed: C904.1, Q906.3 (E), R917.1, R919.1, R922.2
unnamed: C905.1, R918.1, R921.1, R924.2
unnamed: C906.1, Q909.3 (E), R923.1, R930.1
unnamed: C907.1, Q911.2 (B), R926.2
unnamed: C908.1, Q912.2 (B), R927.2
unnamed: C909.2, D903.1 (K), Q911.1 (C)
unnamed: C910.2, D904.1 (K), Q912.1 (C)
unnamed: C911.2, C913.1, D903.2 (A), R930.2
unnamed: C912.2, C914.1, D904.2 (A), R931.2
unnamed: C913.2, C915.1, R932.1
unnamed: C914.2, C916.1, R933.1
unnamed: C915.2, Q913.2 (B), R934.1
unnamed: C916.2, Q914.2 (B), R935.1
unnamed: C917.1, Q913.3 (E), R932.2, R936.1
unnamed: C917.2, R938.2
unnamed: C918.1, Q914.3 (E), R933.2, R937.1
unnamed: C918.2, R939.2
unnamed: C919.1, R944.2
unnamed: C919.2, C921.1, R938.1, R942.2, U901.6 (-)
unnamed: C920.1, R945.2
unnamed: C920.2, C922.1, R939.1, R943.2, U901.2 (-)
unnamed: C921.2, R942.1, R944.1, R947.2, U901.7
unnamed: C922.2, R943.1, R945.1, R946.2, U901.1
unnamed: Q901.1 (C), R906.2
unnamed: Q901.2 (B), R903.2, R904.1
unnamed: Q902.1 (C), R907.1, R920.2
unnamed: Q902.2 (B), R905.2, R906.1
unnamed: Q902.3 (E), Q905.3 (E), Q915.1 (C), R905.1, R910.1, RV626.1
unnamed: Q903.1 (C), R911.2
unnamed: Q903.2 (B), R908.2, R909.1
unnamed: Q904.2 (B), R912.2, R913.1, RV624.2, RV624.3
unnamed: Q905.1 (C), R912.1, R915.2
unnamed: Q905.2 (B), R910.2, R911.1
unnamed: Q906.1 (C), R918.2
unnamed: Q906.2 (B), R915.1
unnamed: Q907.1 (C), Q908.1 (C), R917.2
unnamed: Q907.2 (B), R916.1
unnamed: Q908.2 (B), R923.2
unnamed: Q909.1 (C), R924.1
unnamed: Q909.2 (B), R920.1
unnamed: Q910.2 (B), R922.1
unnamed: Q910.3 (E), R925.2, R931.1
unnamed: Q911.3 (E), R928.1
unnamed: Q912.3 (E), R929.1
unnamed: Q915.2 (B), Q917.1 (C), R950.2
unnamed: Q916.1 (C), R951.1
unnamed: Q916.2 (B), R948.1
unnamed: Q917.2 (B), R949.1
unnamed: R914.1, RV624.1
unnamed: R940.2, U901.5 (+)
unnamed: R941.2, U901.3 (+)
unnamed: R951.2, RV626.2, RV626.3
OHTrig: D901.2 (A)
OpenHatFull: R947.1

Notes on the sheet:
Decay - 2M
