hsetlik/ESP808_mk3/Schematic/IO.kicad_sch

## KiCad design Schematic/IO.kicad_sch (2024-04-10)

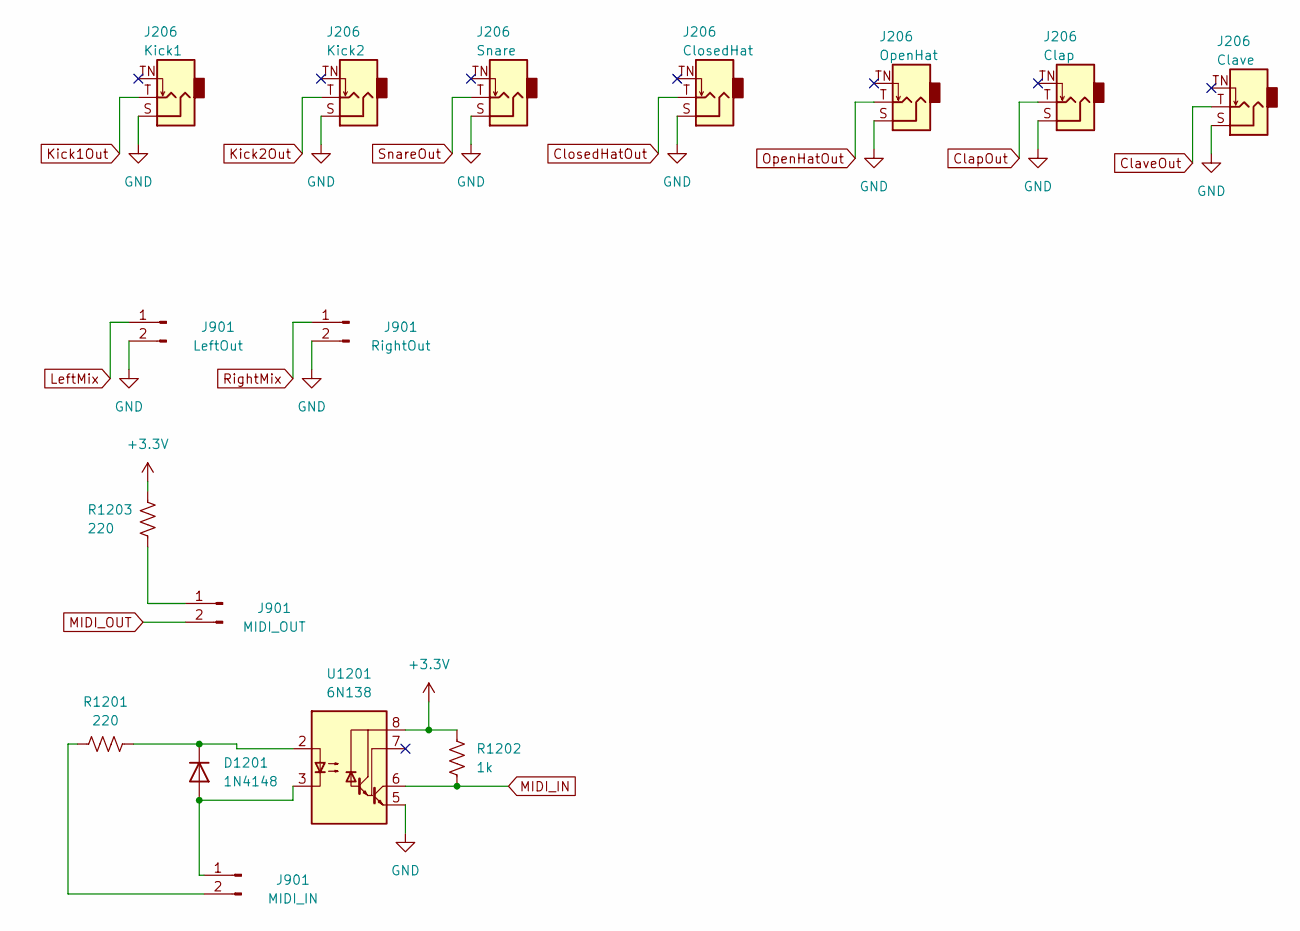
[picture p8: schematic IO.kicad_sch]

Parts:
D1201: 1N4148; D_SOD-123
J206: ClosedHat; Jack_3.5mm_PJ323_THT_Horizontal
J901: RightOut; PinHeader_1x02_P2.54mm_Vertical
R1201, R1203: 220; R_0805_2012Metric
R1202: 1k; R_0805_2012Metric
U1201: 6N138; DIP-8_W7.62mm_Socket

Connections:
+3.3V: R1202.2, R1203.2, U1201.8 (VCC)
ClapOut: J206.T
ClaveOut: J206.T
ClosedHatOut: J206.T
GND: J206.S, J901.2, U1201.5 (GND)
Kick1Out: J206.T
Kick2Out: J206.T
LeftMix: J901.1
MIDI_IN: R1202.1, U1201.6 (VO2)
MIDI_OUT: J901.2
unnamed: D1201.1 (K), R1201.2, U1201.2 (C1)
unnamed: D1201.2 (A), J901.1, U1201.3 (C2)
unnamed: J901.1, R1203.1
unnamed: J901.2, R1201.1
OpenHatOut: J206.T
RightMix: J901.1
SnareOut: J206.T
