hsetlik/ESP808_mk3/Schematic/Kicks.kicad_sch

## KiCad design Schematic/Kicks.kicad_sch (2024-04-10)

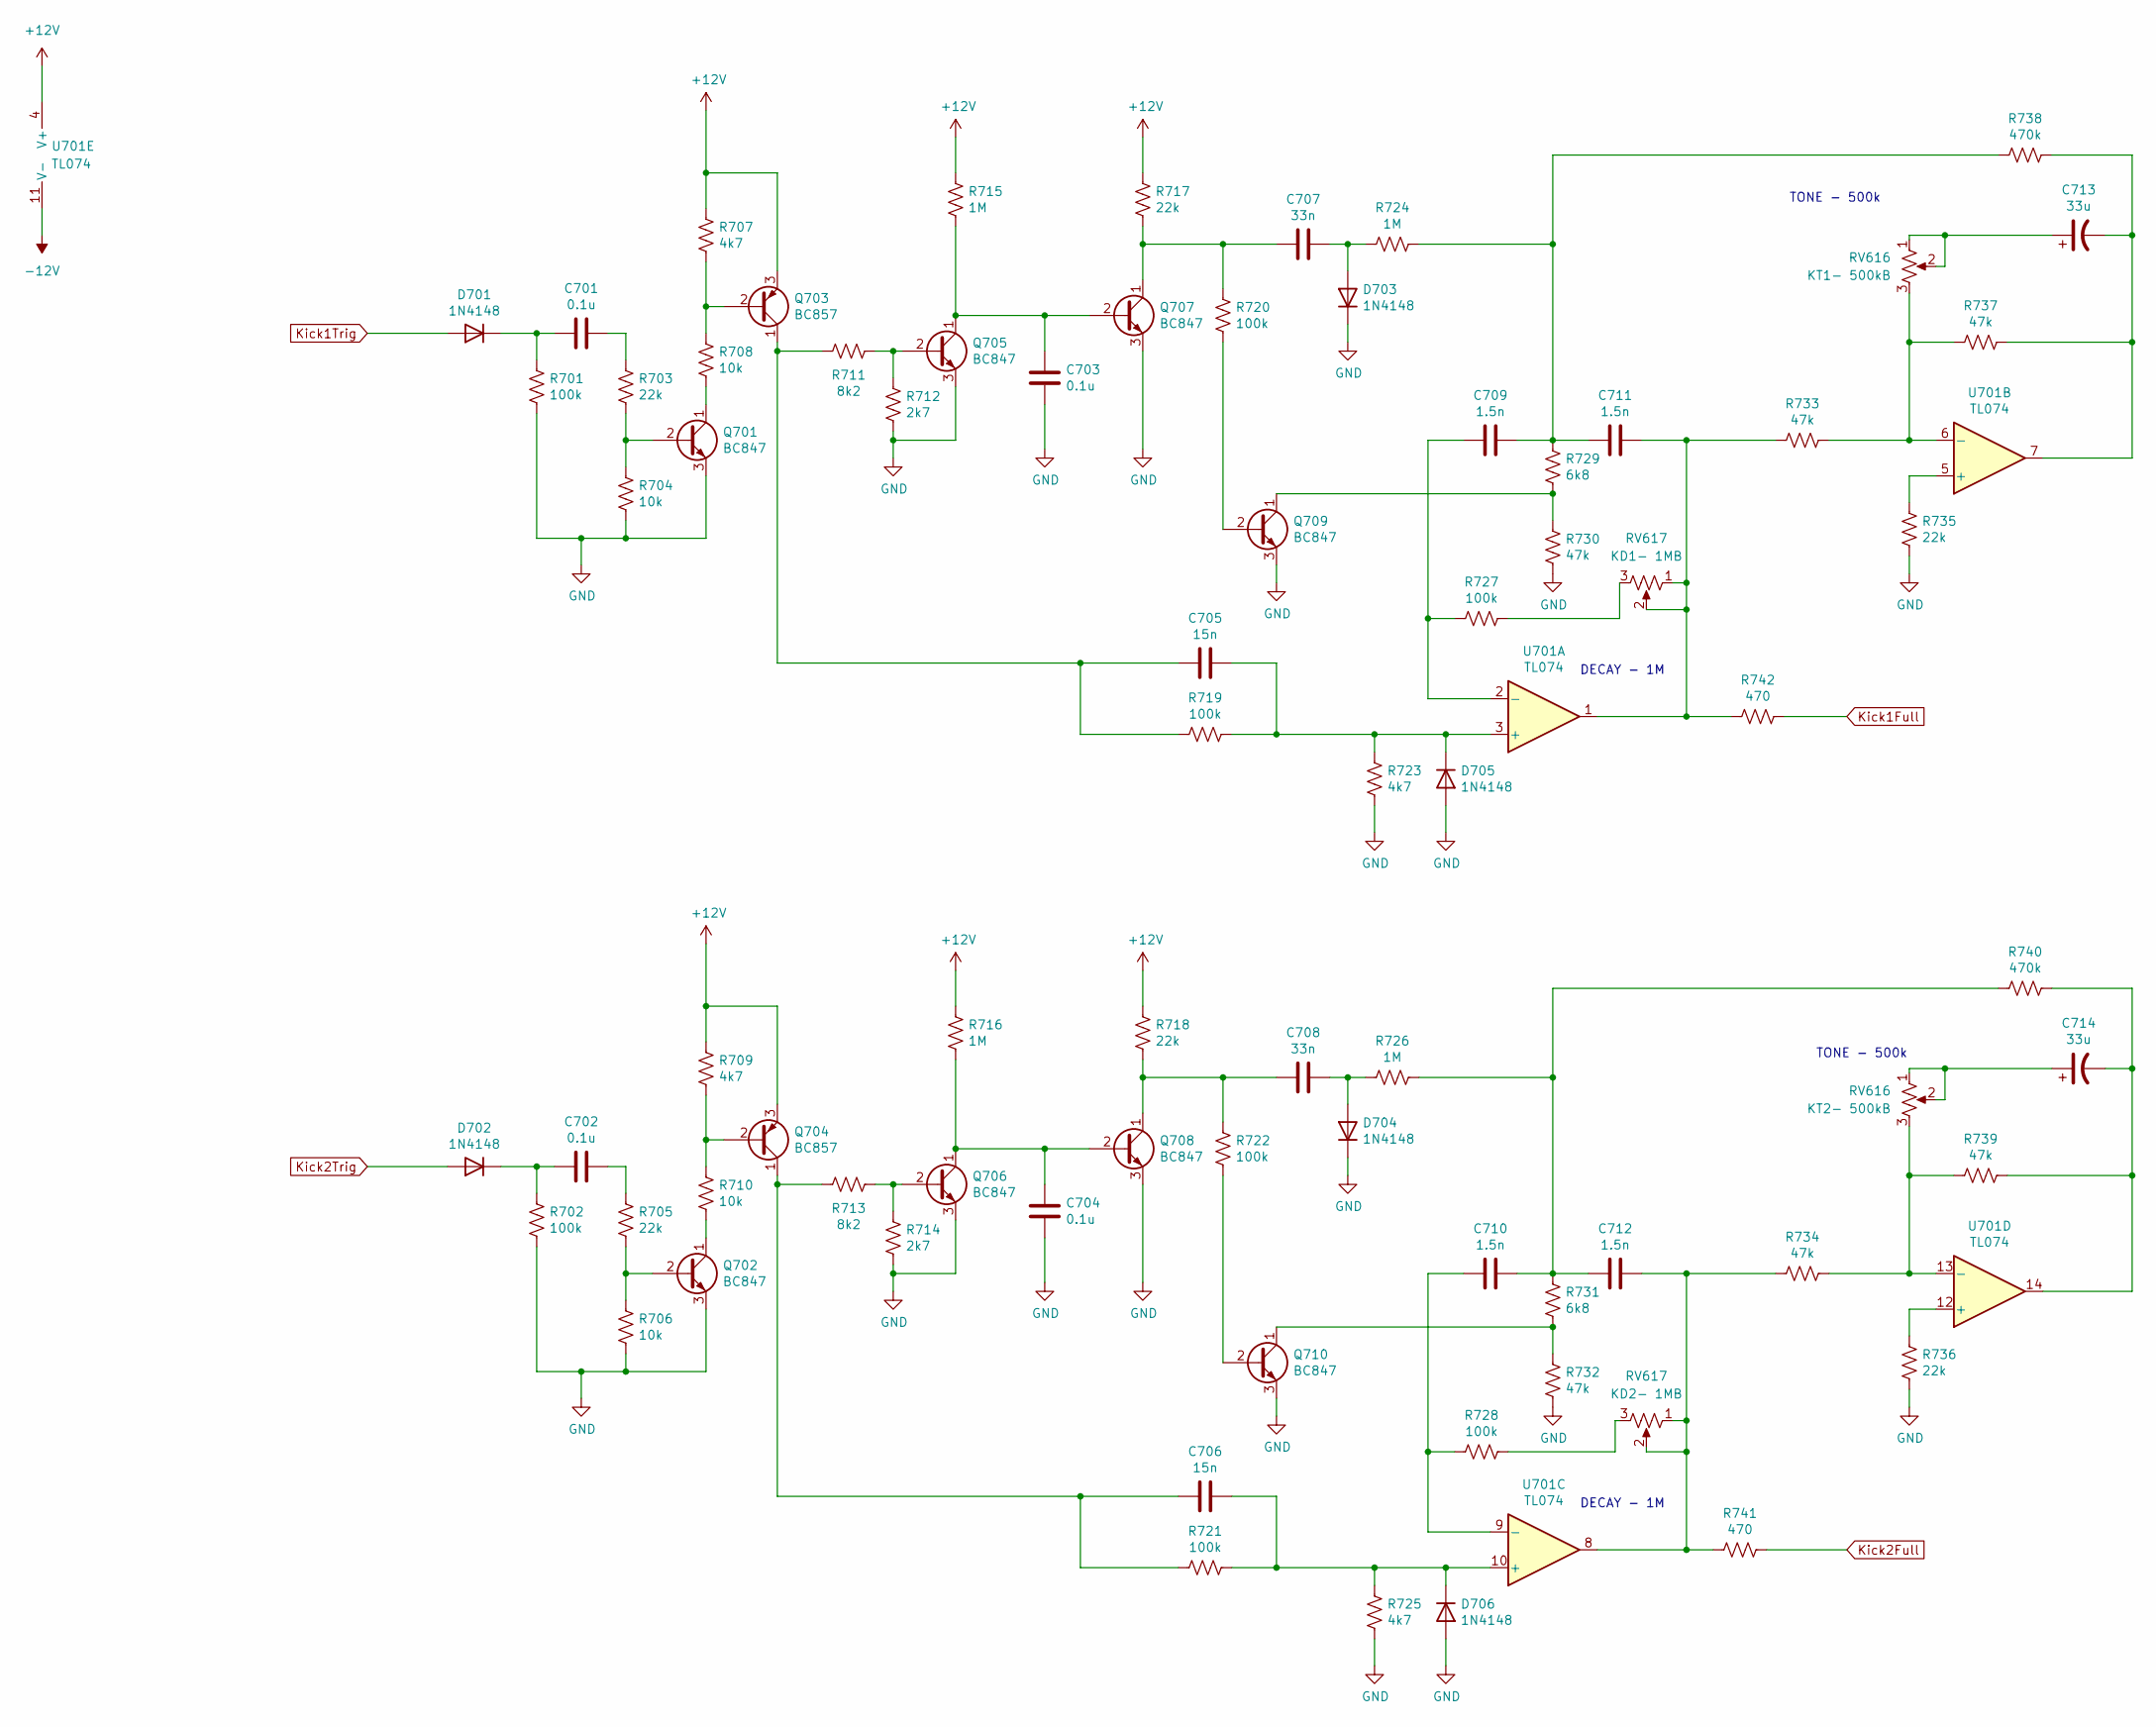
[picture p9: schematic Kicks.kicad_sch]

Parts:
C701, C702, C703, C704: 0.1u; C_0805_2012Metric
C705, C706: 15n; C_0805_2012Metric
C707, C708: 33n; C_0805_2012Metric
C709, C710, C711, C712: 1.5n; C_0805_2012Metric
C713, C714: 33u; CP_Radial_D5.0mm_P2.00mm
D701, D702, D703, D704, D705, D706: 1N4148; D_SOD-123
Q701, Q702, Q705, Q706, Q707, Q708, Q709, Q710: BC847; SOT-23
Q703, Q704: BC857; SOT-23
R701, R702, R719, R720, R721, R722, R727, R728: 100k; R_0805_2012Metric
R703, R705, R717, R718, R735, R736: 22k; R_0805_2012Metric
R704, R706, R708, R710: 10k; R_0805_2012Metric
R707, R709, R723, R725: 4k7; R_0805_2012Metric
R711, R713: 8k2; R_0805_2012Metric
R712, R714: 2k7; R_0805_2012Metric
R715, R716, R724, R726: 1M; R_0805_2012Metric
R729, R731: 6k8; R_0805_2012Metric
R730, R732, R733, R734, R737, R739: 47k; R_0805_2012Metric
R738, R740: 470k; R_0805_2012Metric
R741, R742: 470; R_0805_2012Metric
RV616: KT2- 500kB; Potentiometer_Alpha_RD901F-40-00D_Single_Vertical
RV617: KD2- 1MB; Potentiometer_Alpha_RD901F-40-00D_Single_Vertical
U701: TL074; SOIC-14_3.9x8.7mm_P1.27mm

Connections:
+12V: Q703.3 (E), Q704.3 (E), R707.1, R709.1, R715.1, R716.1, R717.1, R718.1, U701.4 (V+)
-12V: U701.11 (V-)
GND: C703.2, C704.2, D703.1 (K), D704.1 (K), D705.2 (A), D706.2 (A), Q701.3 (E), Q702.3 (E), Q705.3 (E), Q706.3 (E), Q707.3 (E), Q708.3 (E), Q709.3 (E), Q710.3 (E), R701.2, R702.2, R704.2, R706.2, R712.1, R714.1, R723.1, R725.1, R730.1, R732.1, R735.1, R736.1
Kick1Full: R742.1
Kick1Trig: D701.2 (A)
Kick2Full: R741.1
Kick2Trig: D702.2 (A)
unnamed: C701.1, R703.1
unnamed: C701.2, D701.1 (K), R701.1
unnamed: C702.1, R705.1
unnamed: C702.2, D702.1 (K), R702.1
unnamed: C703.1, Q705.1 (C), Q707.2 (B), R715.2
unnamed: C704.1, Q706.1 (C), Q708.2 (B), R716.2
unnamed: C705.1, D705.1 (K), R719.2, R723.2, U701.3 (+)
unnamed: C705.2, Q703.1 (C), R711.2, R719.1
unnamed: C706.1, D706.1 (K), R721.2, R725.2, U701.10 (+)
unnamed: C706.2, Q704.1 (C), R713.2, R721.1
unnamed: C707.1, D703.2 (A), R724.1
unnamed: C707.2, Q707.1 (C), R717.2, R720.2
unnamed: C708.1, D704.2 (A), R726.1
unnamed: C708.2, Q708.1 (C), R718.2, R722.2
unnamed: C709.1, C711.2, R724.2, R729.2, R738.1
unnamed: C709.2, R727.2, U701.2 (-)
unnamed: C710.1, C712.2, R726.2, R731.2, R740.1
unnamed: C710.2, R728.2, U701.9 (-)
unnamed: C711.1, R733.2, R742.2, RV617.1, RV617.2, U701.1
unnamed: C712.1, R734.2, R741.2, RV617.1, RV617.2, U701.8
unnamed: C713.1, RV616.1, RV616.2
unnamed: C713.2, R737.2, R738.2, U701.7
unnamed: C714.1, RV616.1, RV616.2
unnamed: C714.2, R739.2, R740.2, U701.14
unnamed: Q701.1 (C), R708.2
unnamed: Q701.2 (B), R703.2, R704.1
unnamed: Q702.1 (C), R710.2
unnamed: Q702.2 (B), R705.2, R706.1
unnamed: Q703.2 (B), R707.2, R708.1
unnamed: Q704.2 (B), R709.2, R710.1
unnamed: Q705.2 (B), R711.1, R712.2
unnamed: Q706.2 (B), R713.1, R714.2
unnamed: Q709.1 (C), R729.1, R730.2
unnamed: Q709.2 (B), R720.1
unnamed: Q710.1 (C), R731.1, R732.2
unnamed: Q710.2 (B), R722.1
unnamed: R727.1, RV617.3
unnamed: R728.1, RV617.3
unnamed: R733.1, R737.1, RV616.3, U701.6 (-)
unnamed: R734.1, R739.1, RV616.3, U701.13 (-)
unnamed: R735.2, U701.5 (+)
unnamed: R736.2, U701.12 (+)

Notes on the sheet:
TONE - 500k
DECAY - 1M
