hsetlik/ESP808_mk3/Schematic/MCU.kicad_sch

## KiCad design Schematic/MCU.kicad_sch (2024-04-11)

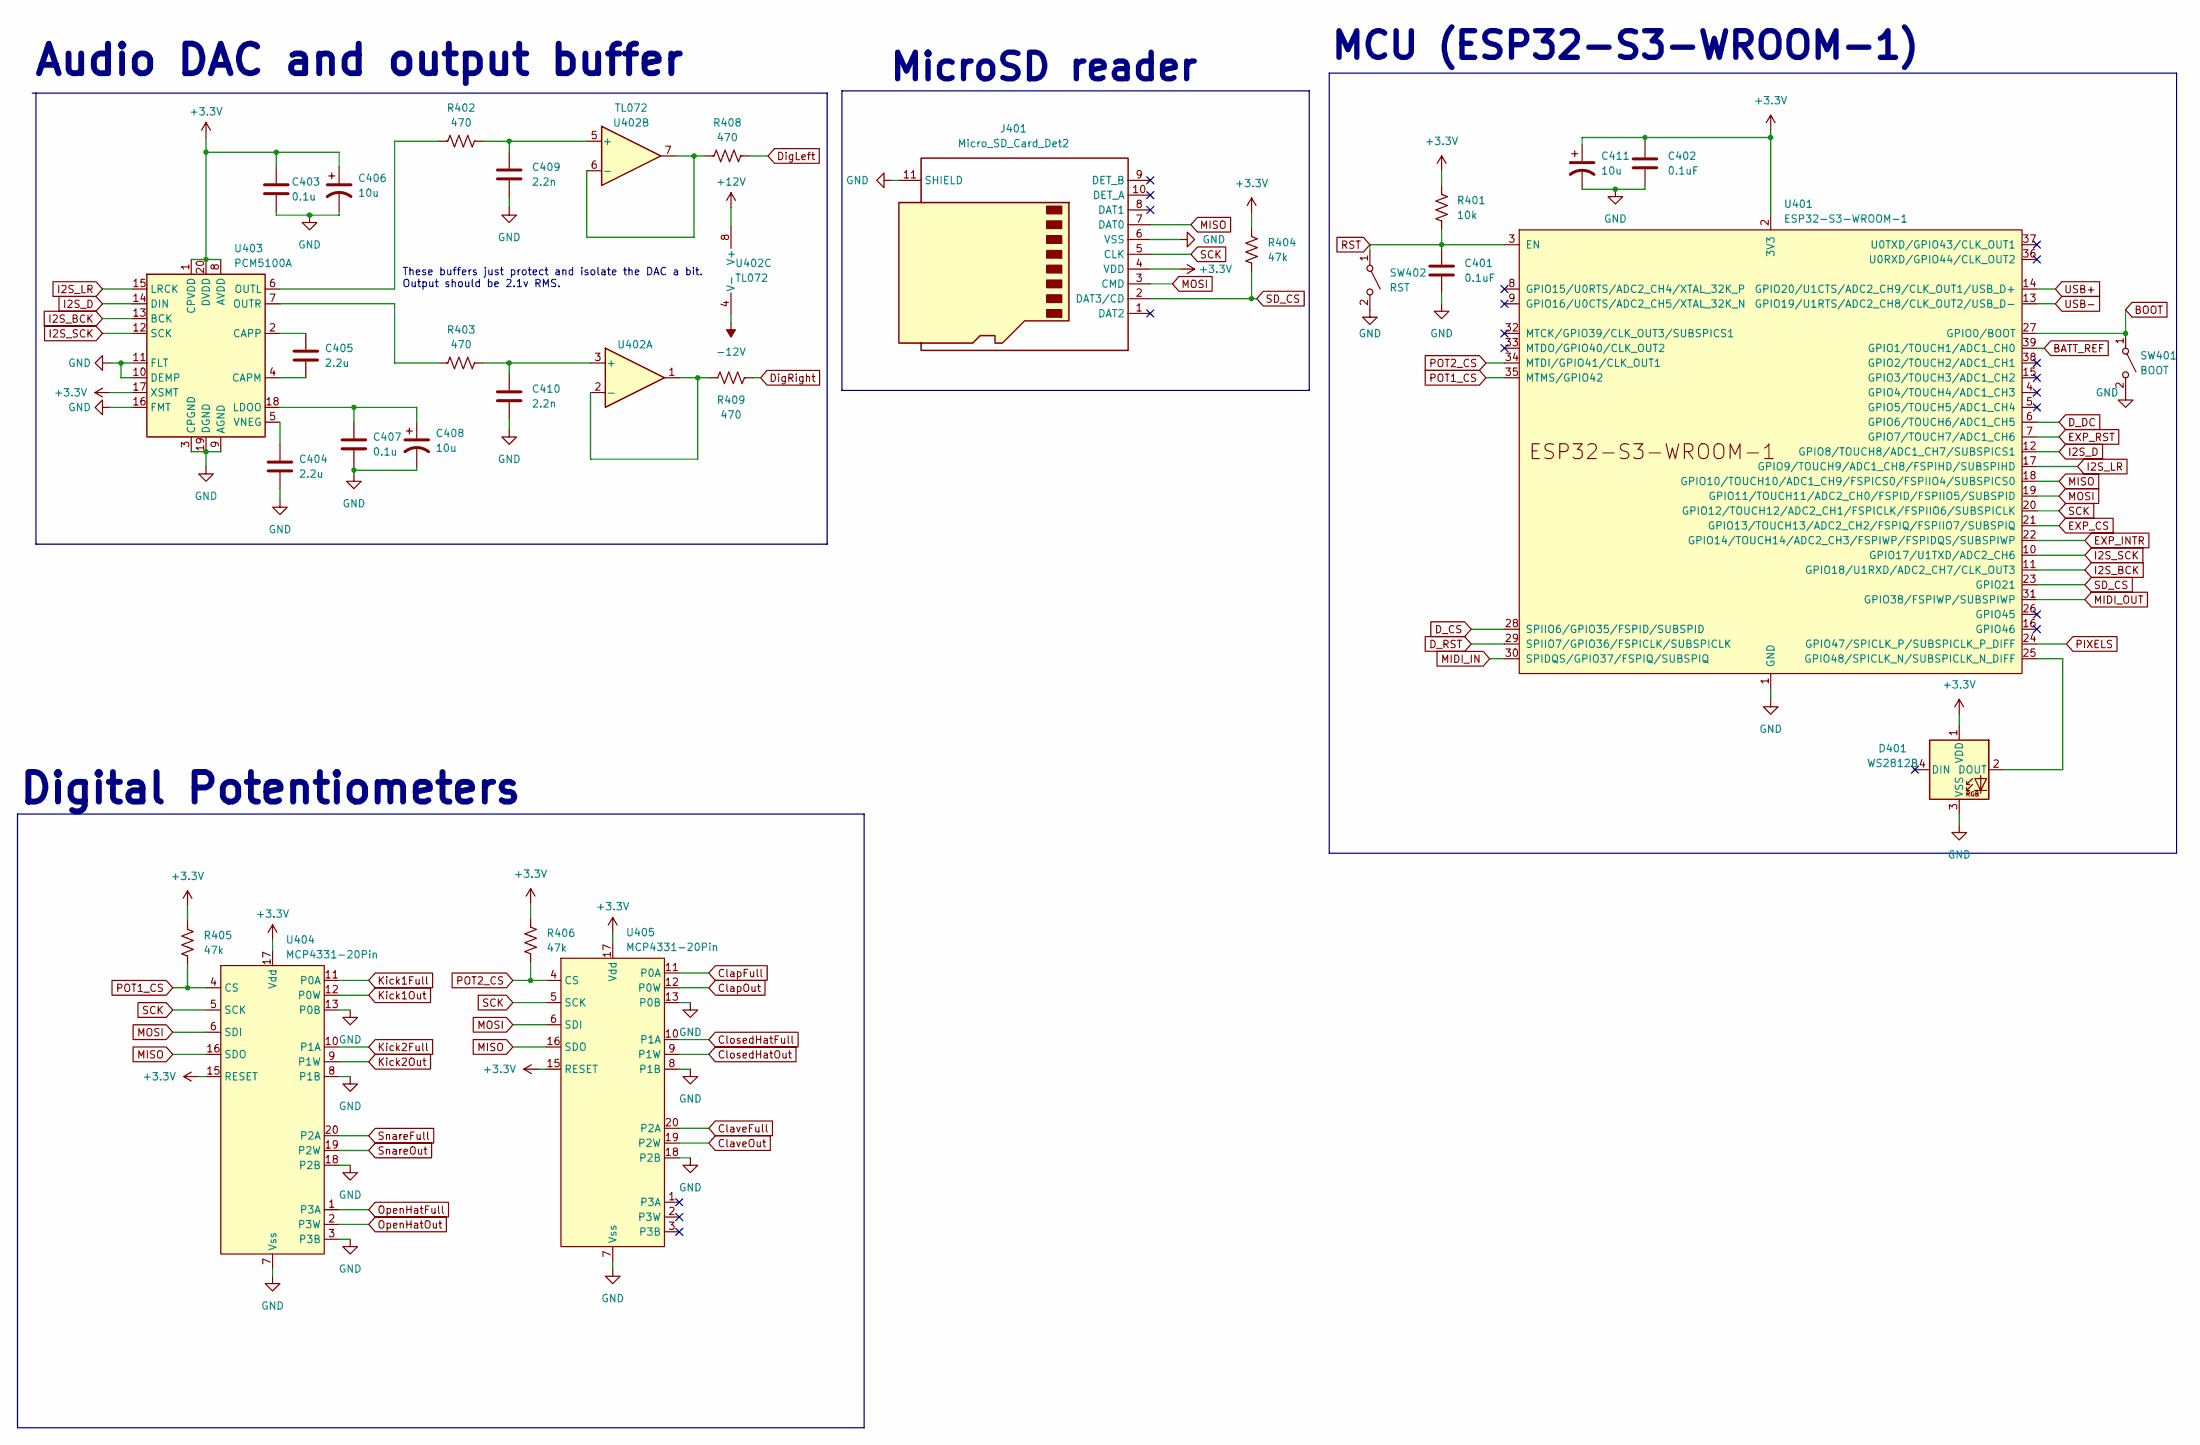
[picture p10: schematic MCU.kicad_sch]

Parts:
C401, C402: 0.1uF; C_0805_2012Metric
C403, C407: 0.1u; C_0805_2012Metric
C404, C405: 2.2u; C_0805_2012Metric
C406, C408, C411: 10u; CP_Radial_D4.0mm_P2.00mm
C409, C410: 2.2n; C_0805_2012Metric
D401: WS2812B; LED_WS2812B_PLCC4_5.0x5.0mm_P3.2mm
J401: Micro_SD_Card_Det2; microSD_HC_Hirose_DM3D-SF
R401: 10k; R_0805_2012Metric
R402, R403, R408, R409: 470; R_0805_2012Metric
R404, R405, R406: 47k; R_0805_2012Metric
SW401: BOOT; SW_SPST_B3U-1000P
SW402: RST; SW_SPST_B3U-1000P
U401: ESP32-S3-WROOM-1
U402: TL072; SOIC-8_3.9x4.9mm_P1.27mm
U403: PCM5100A; TSSOP-20_4.4x6.5mm_P0.65mm
U404, U405: MCP4331-20Pin; TSSOP-20_4.4x6.5mm_P0.65mm

Connections:
+3.3V: C402.1, C403.1, C406.1, C411.1, D401.1 (VDD), J401.4 (VDD), R401.1, R404.1, R405.1, R406.1, U401.2 (3V3), U403.1 (CPVDD), U403.8 (AVDD), U403.17 (XSMT), U403.20 (DVDD), U404.15 (RESET), U404.17 (Vdd), U405.15 (RESET), U405.17 (Vdd)
+12V: U402.8 (V+)
-12V: U402.4 (V-)
BATT_REF: U401.39 (GPIO1/TOUCH1/ADC1_CH0)
BOOT: SW401.1 (A), U401.27 (GPIO0/BOOT)
ClapFull: U405.11 (P0A)
ClapOut: U405.12 (P0W)
ClaveFull: U405.20 (P2A)
ClaveOut: U405.19 (P2W)
ClosedHatFull: U405.10 (P1A)
ClosedHatOut: U405.9 (P1W)
D_CS: U401.28 (SPIIO6/GPIO35/FSPID/SUBSPID)
D_DC: U401.6 (GPIO6/TOUCH6/ADC1_CH5)
D_RST: U401.29 (SPIIO7/GPIO36/FSPICLK/SUBSPICLK)
DigLeft: R408.2
DigRight: R409.2
EXP_CS: U401.21 (GPIO13/TOUCH13/ADC2_CH2/FSPIQ/FSPIIO7/S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)
EXP_INTR: U401.22 (GPIO14/TOUCH14/ADC2_CH3/FSPIWP/FSPIDQS/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)
EXP_RST: U401.7 (GPIO7/TOUCH7/ADC1_CH6)
GND: C401.2, C402.2, C403.2, C404.2, C406.2, C407.2, C408.2, C409.2, C410.2, C411.2, D401.3 (VSS), J401.6 (VSS), J401.11 (SHIELD), SW401.2 (B), SW402.2 (B), U401.1 (GND), U401.40 (GND), U401.41 (GND), U403.3 (CPGND), U403.9 (AGND), U403.10 (DEMP), U403.11 (FLT), U403.16 (FMT), U403.19 (DGND), U404.3 (P3B), U404.7 (Vss), U404.8 (P1B), U404.13 (P0B), U404.18 (P2B), U405.7 (Vss), U405.8 (P1B), U405.13 (P0B), U405.18 (P2B)
I2S_BCK: U401.11 (GPIO18/U1RXD/ADC2_CH7/CLK_OUT3), U403.13 (BCK)
I2S_D: U401.12 (GPIO8/TOUCH8/ADC1_CH7/SUBSPICS1), U403.14 (DIN)
I2S_LR: U401.17 (GPIO9/TOUCH9/ADC1_CH8/FSPIHD/SUBSPIHD), U403.15 (LRCK)
I2S_SCK: U401.10 (GPIO17/U1TXD/ADC2_CH6), U403.12 (SCK)
Kick1Full: U404.11 (P0A)
Kick1Out: U404.12 (P0W)
Kick2Full: U404.10 (P1A)
Kick2Out: U404.9 (P1W)
MIDI_IN: U401.30 (SPIDQS/GPIO37/FSPIQ/SUBSPIQ)
MIDI_OUT: U401.31 (GPIO38/FSPIWP/SUBSPIWP)
MISO: J401.7 (DAT0), U401.18 (GPIO10/TOUCH10/ADC1_CH9/FSPICS0/FSPIIO4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), U404.16 (SDO), U405.16 (SDO)
MOSI: J401.3 (CMD), U401.19 (GPIO11/TOUCH11/ADC2_CH0/FSPID/FSPIIO5/S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), U404.6 (SDI), U405.6 (SDI)
unnamed: C404.1, U403.5 (VNEG)
unnamed: C405.1, U403.2 (CAPP)
unnamed: C405.2, U403.4 (CAPM)
unnamed: C407.1, C408.1, U403.18 (LDOO)
unnamed: C409.1, R402.2, U402.5 (+)
unnamed: C410.1, R403.2, U402.3 (+)
unnamed: D401.2 (DOUT), U401.25 (GPIO48/SPICLK_N/SUBSPICLK_N_DIFF)
unnamed: R402.1, U403.6 (OUTL)
unnamed: R403.1, U403.7 (OUTR)
unnamed: R408.1, U402.6 (-), U402.7
unnamed: R409.1, U402.1, U402.2 (-)
OpenHatFull: U404.1 (P3A)
OpenHatOut: U404.2 (P3W)
PIXELS: U401.24 (GPIO47/SPICLK_P/SUBSPICLK_P_DIFF)
POT1_CS: R405.2, U401.35 (MTMS/GPIO42), U404.4 (CS)
POT2_CS: R406.2, U401.34 (MTDI/GPIO41/CLK_OUT1), U405.4 (CS)
RST: C401.1, R401.2, SW402.1 (A), U401.3 (EN)
SCK: J401.5 (CLK), U401.20 (GPIO12/TOUCH12/ADC2_CH1/FSPICLK/FSPIIO6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), U404.5 (SCK), U405.5 (SCK)
SD_CS: J401.2 (DAT3/CD), R404.2, U401.23 (GPIO21)
SnareFull: U404.20 (P2A)
SnareOut: U404.19 (P2W)
USB+: U401.14 (GPIO20/U1CTS/ADC2_CH9/CLK_OUT1/USB_D+)
USB-: U401.13 (GPIO19/U1RTS/ADC2_CH8/CLK_OUT2/USB_D-)

Notes on the sheet:
These buffers just protect and isolate the DAC a bit. Output should be 2.1v RMS.
MCU (ESP32-S3-WROOM-1)
MicroSD reader
Digital Potentiometers
Audio DAC and output buffer
