hsetlik/ESP808_mk3/Schematic/Mixer.kicad_sch

## KiCad design Schematic/Mixer.kicad_sch (2024-04-10)

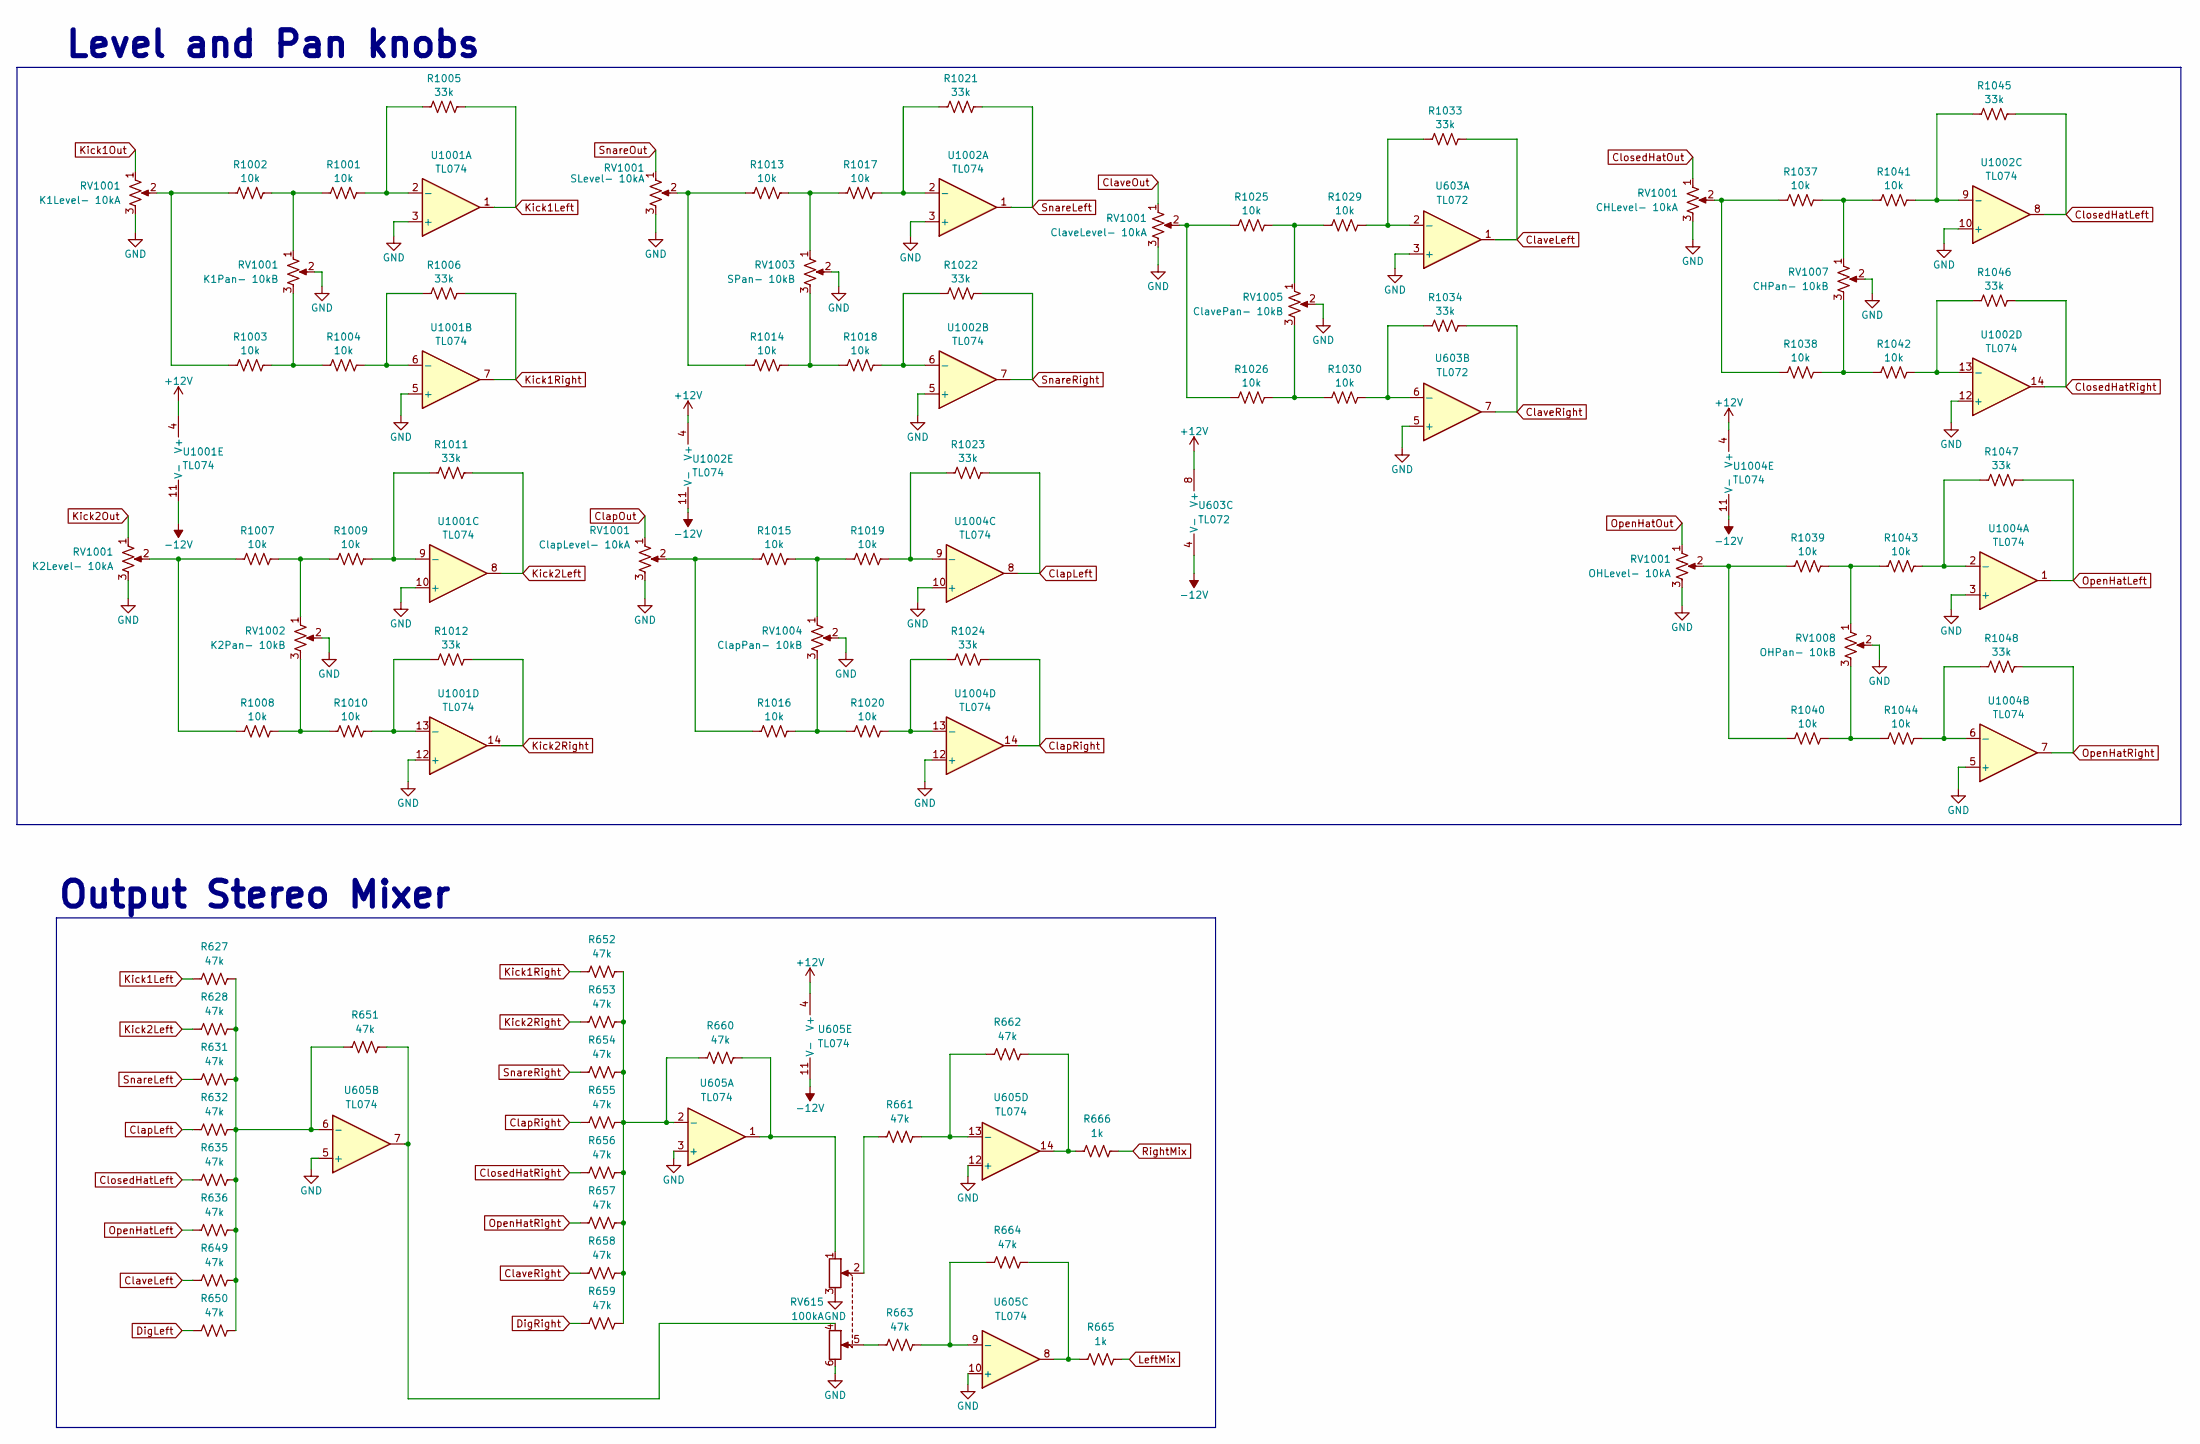
[picture p11: schematic Mixer.kicad_sch]

Parts:
R627, R628, R631, R632, R635, R636, R649, R650, R651, R652, R653, R654, R655, R656, R657, R658, R659, R660, R661, R662, R663, R664: 47k; R_0805_2012Metric
R665, R666: 1k; R_0805_2012Metric
R1001, R1002, R1003, R1004, R1007, R1008, R1009, R1010, R1013, R1014, R1015, R1016, R1017, R1018, R1019, R1020, R1025, R1026, R1029, R1030, R1037, R1038, R1039, R1040, R1041, R1042, R1043, R1044: 10k; R_0805_2012Metric
R1005, R1006, R1011, R1012, R1021, R1022, R1023, R1024, R1033, R1034, R1045, R1046, R1047, R1048: 33k; R_0805_2012Metric
RV615: 100kA; Potentiometer_Alpha_RD902F-40-00D_Dual_Vertical
RV1001: SLevel- 10kA; Potentiometer_Alpha_RD901F-40-00D_Single_Vertical
RV1002: K2Pan- 10kB; Potentiometer_Alpha_RD901F-40-00D_Single_Vertical
RV1003: SPan- 10kB; Potentiometer_Alpha_RD901F-40-00D_Single_Vertical
RV1004: ClapPan- 10kB; Potentiometer_Alpha_RD901F-40-00D_Single_Vertical
RV1005: ClavePan- 10kB; Potentiometer_Alpha_RD901F-40-00D_Single_Vertical
RV1007: CHPan- 10kB; Potentiometer_Alpha_RD901F-40-00D_Single_Vertical
RV1008: OHPan- 10kB; Potentiometer_Alpha_RD901F-40-00D_Single_Vertical
U603: TL072; SOIC-8_3.9x4.9mm_P1.27mm
U605, U1001, U1002, U1004: TL074; SOIC-14_3.9x8.7mm_P1.27mm

Connections:
+12V: U603.8 (V+), U605.4 (V+), U1001.4 (V+), U1002.4 (V+), U1004.4 (V+)
-12V: U603.4 (V-), U605.11 (V-), U1001.11 (V-), U1002.11 (V-), U1004.11 (V-)
ClapLeft: R632.1, R1023.2, U1004.8
ClapOut: RV1001.1
ClapRight: R655.1, R1024.2, U1004.14
ClaveLeft: R649.1, R1033.2, U603.1
ClaveOut: RV1001.1
ClaveRight: R658.1, R1034.2, U603.7
ClosedHatLeft: R635.1, R1045.2, U1002.8
ClosedHatOut: RV1001.1
ClosedHatRight: R656.1, R1046.2, U1002.14
DigLeft: R650.1
DigRight: R659.1
GND: RV615.3, RV615.6, RV1001.2, RV1001.3, RV1002.2, RV1003.2, RV1004.2, RV1005.2, RV1007.2, RV1008.2, U603.3 (+), U603.5 (+), U605.3 (+), U605.5 (+), U605.10 (+), U605.12 (+), U1001.3 (+), U1001.5 (+), U1001.10 (+), U1001.12 (+), U1002.3 (+), U1002.5 (+), U1002.10 (+), U1002.12 (+), U1004.3 (+), U1004.5 (+), U1004.10 (+), U1004.12 (+)
Kick1Left: R627.1, R1005.2, U1001.1
Kick1Out: RV1001.1
Kick1Right: R652.1, R1006.2, U1001.7
Kick2Left: R628.1, R1011.2, U1001.8
Kick2Out: RV1001.1
Kick2Right: R653.1, R1012.2, U1001.14
LeftMix: R665.2
unnamed: R627.2, R628.2, R631.2, R632.2, R635.2, R636.2, R649.2, R650.2, R651.1, U605.6 (-)
unnamed: R651.2, RV615.4, U605.7
unnamed: R652.2, R653.2, R654.2, R655.2, R656.2, R657.2, R658.2, R659.2, R660.1, U605.2 (-)
unnamed: R660.2, RV615.1, U605.1
unnamed: R661.1, RV615.2
unnamed: R661.2, R662.1, U605.13 (-)
unnamed: R662.2, R666.1, U605.14
unnamed: R663.1, RV615.5
unnamed: R663.2, R664.1, U605.9 (-)
unnamed: R664.2, R665.1, U605.8
unnamed: R1001.1, R1002.2, RV1001.1
unnamed: R1001.2, R1005.1, U1001.2 (-)
unnamed: R1002.1, R1003.1, RV1001.2
unnamed: R1003.2, R1004.1, RV1001.3
unnamed: R1004.2, R1006.1, U1001.6 (-)
unnamed: R1007.1, R1008.1, RV1001.2
unnamed: R1007.2, R1009.1, RV1002.1
unnamed: R1008.2, R1010.1, RV1002.3
unnamed: R1009.2, R1011.1, U1001.9 (-)
unnamed: R1010.2, R1012.1, U1001.13 (-)
unnamed: R1013.1, R1014.1, RV1001.2
unnamed: R1013.2, R1017.1, RV1003.1
unnamed: R1014.2, R1018.1, RV1003.3
unnamed: R1015.1, R1016.1, RV1001.2
unnamed: R1015.2, R1019.1, RV1004.1
unnamed: R1016.2, R1020.1, RV1004.3
unnamed: R1017.2, R1021.1, U1002.2 (-)
unnamed: R1018.2, R1022.1, U1002.6 (-)
unnamed: R1019.2, R1023.1, U1004.9 (-)
unnamed: R1020.2, R1024.1, U1004.13 (-)
unnamed: R1025.1, R1026.1, RV1001.2
unnamed: R1025.2, R1029.1, RV1005.1
unnamed: R1026.2, R1030.1, RV1005.3
unnamed: R1029.2, R1033.1, U603.2 (-)
unnamed: R1030.2, R1034.1, U603.6 (-)
unnamed: R1037.1, R1038.1, RV1001.2
unnamed: R1037.2, R1041.1, RV1007.1
unnamed: R1038.2, R1042.1, RV1007.3
unnamed: R1039.1, R1040.1, RV1001.2
unnamed: R1039.2, R1043.1, RV1008.1
unnamed: R1040.2, R1044.1, RV1008.3
unnamed: R1041.2, R1045.1, U1002.9 (-)
unnamed: R1042.2, R1046.1, U1002.13 (-)
unnamed: R1043.2, R1047.1, U1004.2 (-)
unnamed: R1044.2, R1048.1, U1004.6 (-)
OpenHatLeft: R636.1, R1047.2, U1004.1
OpenHatOut: RV1001.1
OpenHatRight: R657.1, R1048.2, U1004.7
RightMix: R666.2
SnareLeft: R631.1, R1021.2, U1002.1
SnareOut: RV1001.1
SnareRight: R654.1, R1022.2, U1002.7

Notes on the sheet:
Output Stereo Mixer
Level and Pan knobs
