hsetlik/ESP808_mk3/Schematic/PowerSupply.kicad_sch

## KiCad design Schematic/PowerSupply.kicad_sch (2024-05-01)

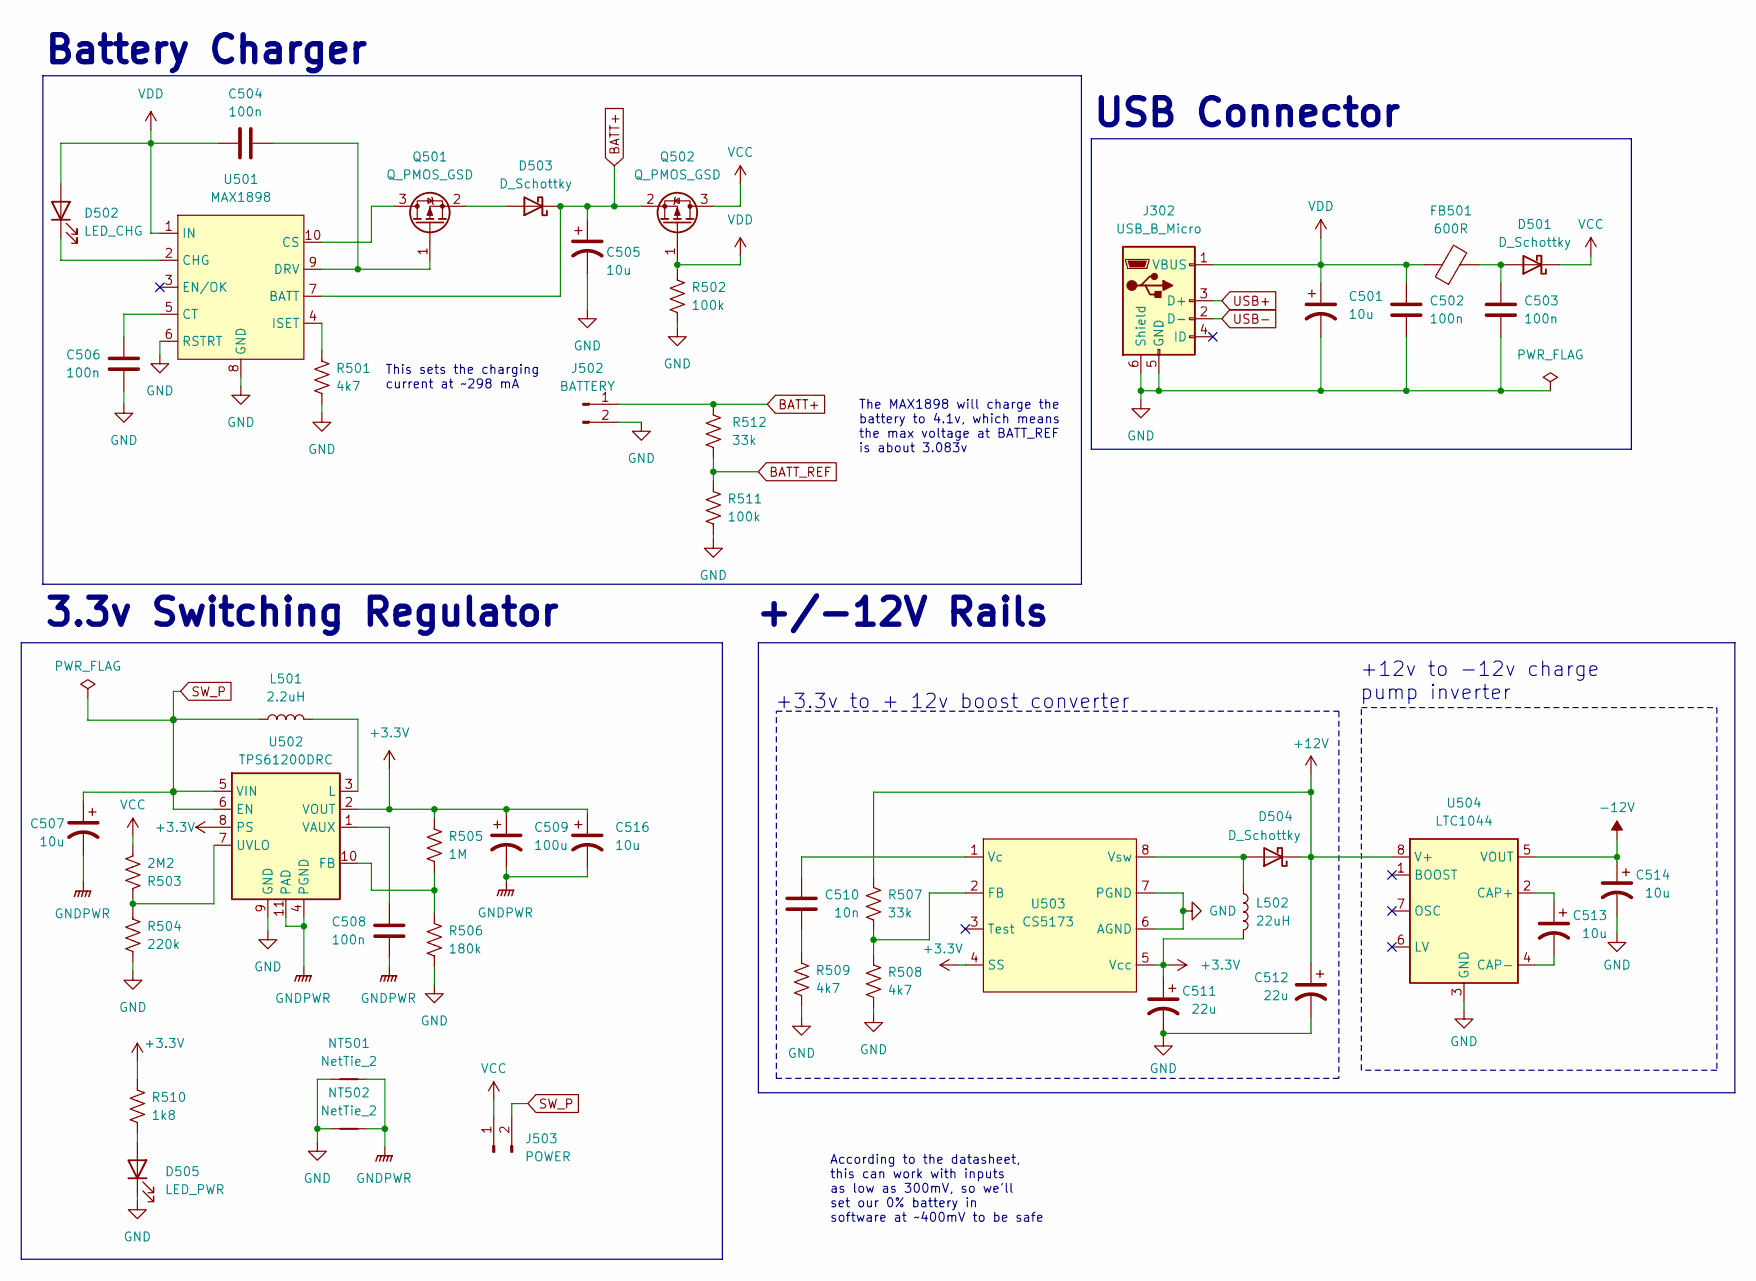
[picture p12: schematic PowerSupply.kicad_sch]

Parts:
C501, C505, C507, C513, C514: 10u; CP_Radial_D4.0mm_P2.00mm
C502, C503, C504, C506, C508: 100n; C_0805_2012Metric
C509: 100u; CP_Radial_D5.0mm_P2.00mm
C510: 10n; C_0805_2012Metric
C511, C512: 22u; CP_Radial_D4.0mm_P2.00mm
C516: 10u; CP_Radial_D5.0mm_P2.00mm
D501, D503, D504: D_Schottky; D_0603_1608Metric
D502: LED_CHG; LED_D3.0mm
D505: LED_PWR; LED_D3.0mm
FB501: 600R; L_0805_2012Metric
J302: USB_B_Micro; USB_Micro-B_Wuerth_629105150521
J502: BATTERY; PinHeader_1x02_P2.54mm_Vertical
J503: POWER; PinHeader_1x02_P2.54mm_Vertical
L501: 2.2uH; L_Changjiang_FNR4010S
L502: 22uH; L_Changjiang_FNR4010S
NT501, NT502: NetTie_2; NetTie-2_SMD_Pad0.5mm
Q501, Q502: Q_PMOS_GSD; SOT-23
R501, R508, R509: 4k7; R_0805_2012Metric
R502, R511: 100k; R_0805_2012Metric
R503: 2M2; R_0805_2012Metric
R504: 220k; R_0805_2012Metric
R505: 1M; R_0805_2012Metric
R506: 180k; R_0805_2012Metric
R507, R512: 33k; R_0805_2012Metric
R510: 1k8; R_0805_2012Metric
U501: MAX1898; MSOP-10_3x3mm_P0.5mm
U502: TPS61200DRC; VSON-10-1EP_3x3mm_P0.5mm_EP1.2x2mm
U503: CS5173; SOIC-8_5.28x4.9mm_Pitch1.27mm
U504: LTC1044; SOIC-8_3.9x4.9mm_P1.27mm

Connections:
+3.3V: C509.1, C511.1, C516.1, L502.2, R505.1, R510.1, U502.2 (VOUT), U502.8 (PS), U503.4 (SS), U503.5 (Vcc)
+12V: C512.1, D504.1 (K), R507.1, U504.8 (V+)
-12V: C514.1, U504.5 (VOUT)
BATT+: C505.1, D503.1 (K), J502.1, Q502.2 (S), R512.1, U501.7 (BATT)
BATT_REF: R511.1, R512.2
GND: C501.2, C502.2, C503.2, C505.2, C506.2, C511.2, C512.2, C514.2, D505.1 (K), J302.5 (GND), J302.6 (Shield), J502.2, NT501.1, NT502.1, R501.2, R502.2, R504.2, R506.2, R508.2, R509.2, R511.2, U501.6 (RSTRT), U501.8 (GND), U502.9 (GND), U503.6 (AGND), U503.7 (PGND), U504.3 (GND)
GNDPWR: C507.2, C508.2, C509.2, C516.2, NT501.2, NT502.2, U502.4 (PGND), U502.11 (PAD)
unnamed: C503.1, D501.2 (A), FB501.2
unnamed: C504.2, Q501.1 (G), U501.9 (DRV)
unnamed: C506.1, U501.5 (CT)
unnamed: C508.1, U502.1 (VAUX)
unnamed: C510.1, U503.1 (Vc)
unnamed: C510.2, R509.1
unnamed: C513.1, U504.2 (CAP+)
unnamed: C513.2, U504.4 (CAP-)
unnamed: D502.1 (K), U501.2 (CHG)
unnamed: D503.2 (A), Q501.2 (S)
unnamed: D504.2 (A), L502.1, U503.8 (Vsw)
unnamed: D505.2 (A), R510.2
unnamed: L501.2, U502.3 (L)
unnamed: Q501.3 (D), U501.10 (CS)
unnamed: R501.1, U501.4 (ISET)
unnamed: R503.1, R504.1, U502.7 (UVLO)
unnamed: R505.2, R506.1, U502.10 (FB)
unnamed: R507.2, R508.1, U503.2 (FB)
SW_P: C507.1, J503.2, L501.1, U502.5 (VIN), U502.6 (EN)
USB+: J302.3 (D+)
USB-: J302.2 (D-)
VCC: D501.1 (K), J503.1, Q502.3 (D), R503.2
VDD: C501.1, C502.1, C504.1, D502.2 (A), FB501.1, J302.1 (VBUS), Q502.1 (G), R502.1, U501.1 (IN)

Notes on the sheet:
According to the datasheet, this can work with inputs as low as 300mV, so we'll set our 0% battery in software at ~400mV to be safe
+12v to -12v charge pump inverter
USB Connector
+/-12V Rails
+3.3v to + 12v boost converter
Battery Charger
The MAX1898 will charge the battery to 4.1v, which means the max voltage at BATT_REF is about 3.083v
This sets the charging current at ~298 mA
3.3v Switching Regulator
