hsetlik/ESP808_mk3/Schematic/Snare.kicad_sch

## KiCad design Schematic/Snare.kicad_sch (2024-04-10)

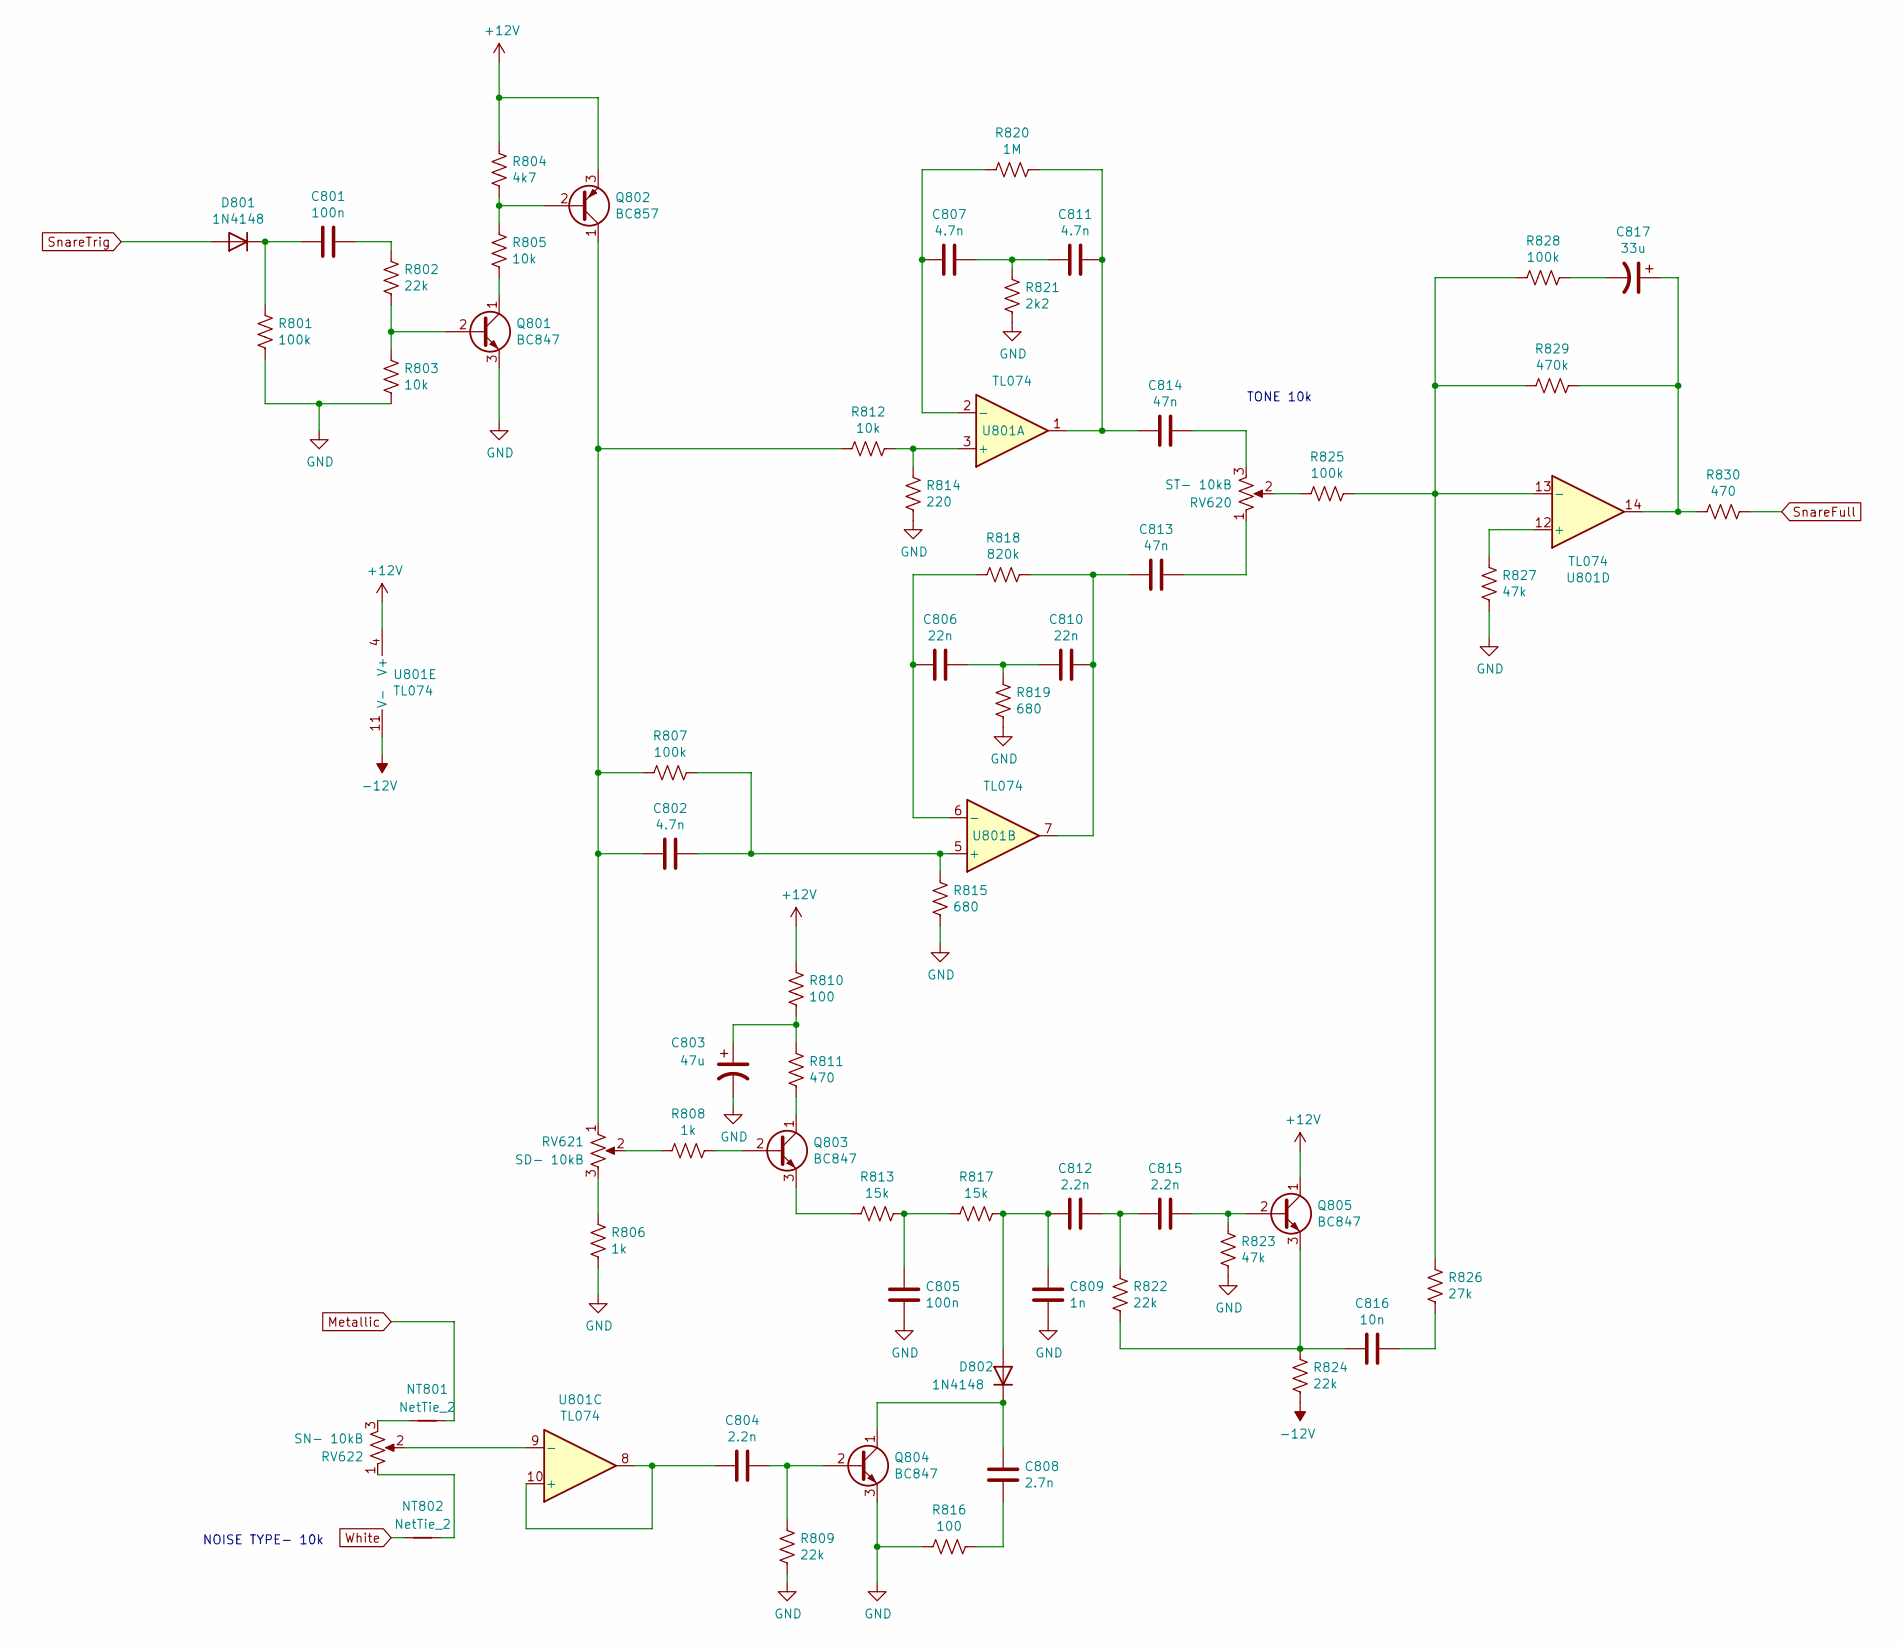
[picture p13: schematic Snare.kicad_sch]

Parts:
C801, C805: 100n; C_0805_2012Metric
C802, C807, C811: 4.7n; C_0805_2012Metric
C803: 47u; CP_Radial_D5.0mm_P2.00mm
C804, C812, C815: 2.2n; C_0805_2012Metric
C806, C810: 22n; C_0805_2012Metric
C808: 2.7n; C_0805_2012Metric
C809: 1n; C_0805_2012Metric
C813, C814: 47n; C_0805_2012Metric
C816: 10n; C_0805_2012Metric
C817: 33u; CP_Radial_D5.0mm_P2.00mm
D801, D802: 1N4148; D_SOD-123
NT801, NT802: NetTie_2; NetTie-2_SMD_Pad0.5mm
Q801, Q803, Q804, Q805: BC847; SOT-23
Q802: BC857; SOT-23
R801, R807, R825, R828: 100k; R_0805_2012Metric
R802, R809, R822, R824: 22k; R_0805_2012Metric
R803, R805, R812: 10k; R_0805_2012Metric
R804: 4k7; R_0805_2012Metric
R806, R808: 1k; R_0805_2012Metric
R810, R816: 100; R_0805_2012Metric
R811, R830: 470; R_0805_2012Metric
R813, R817: 15k; R_0805_2012Metric
R814: 220; R_0805_2012Metric
R815, R819: 680; R_0805_2012Metric
R818: 820k; R_0805_2012Metric
R820: 1M; R_0805_2012Metric
R821: 2k2; R_0805_2012Metric
R823, R827: 47k; R_0805_2012Metric
R826: 27k; R_0805_2012Metric
R829: 470k; R_0805_2012Metric
RV620: ST- 10kB; Potentiometer_Alpha_RD901F-40-00D_Single_Vertical
RV621: SD- 10kB; Potentiometer_Alpha_RD901F-40-00D_Single_Vertical
RV622: SN- 10kB; Potentiometer_Alpha_RD901F-40-00D_Single_Vertical
U801: TL074; SOIC-14_3.9x8.7mm_P1.27mm

Connections:
+12V: Q802.3 (E), Q805.1 (C), R804.1, R810.1, U801.4 (V+)
-12V: R824.1, U801.11 (V-)
GND: C803.2, C805.1, C809.1, Q801.3 (E), Q804.3 (E), R801.2, R803.2, R806.2, R809.2, R814.1, R815.2, R816.2, R819.2, R821.2, R823.1, R827.2
Metallic: NT801.2
unnamed: C801.1, R802.1
unnamed: C801.2, D801.1 (K), R801.1
unnamed: C802.1, R807.1, R815.1, U801.5 (+)
unnamed: C802.2, Q802.1 (C), R807.2, R812.2, RV621.1
unnamed: C803.1, R810.2, R811.1
unnamed: C804.1, Q804.2 (B), R809.1
unnamed: C804.2, U801.8, U801.10 (+)
unnamed: C805.2, R813.1, R817.2
unnamed: C806.1, C810.2, R819.1
unnamed: C806.2, R818.2, U801.6 (-)
unnamed: C807.1, C811.2, R821.1
unnamed: C807.2, R820.2, U801.2 (-)
unnamed: C808.1, R816.1
unnamed: C808.2, D802.1 (K), Q804.1 (C)
unnamed: C809.2, C812.2, D802.2 (A), R817.1
unnamed: C810.1, C813.2, R818.1, U801.7
unnamed: C811.1, C814.2, R820.1, U801.1
unnamed: C812.1, C815.2, R822.2
unnamed: C813.1, RV620.1
unnamed: C814.1, RV620.3
unnamed: C815.1, Q805.2 (B), R823.2
unnamed: C816.1, R826.1
unnamed: C816.2, Q805.3 (E), R822.1, R824.2
unnamed: C817.1, R829.1, R830.2, U801.14
unnamed: C817.2, R828.1
unnamed: NT801.1, RV622.3
unnamed: NT802.2, RV622.1
unnamed: Q801.1 (C), R805.2
unnamed: Q801.2 (B), R802.2, R803.1
unnamed: Q802.2 (B), R804.2, R805.1
unnamed: Q803.1 (C), R811.2
unnamed: Q803.2 (B), R808.1
unnamed: Q803.3 (E), R813.2
unnamed: R806.1, RV621.3
unnamed: R808.2, RV621.2
unnamed: R812.1, R814.2, U801.3 (+)
unnamed: R825.1, R826.2, R828.2, R829.2, U801.13 (-)
unnamed: R825.2, RV620.2
unnamed: R827.1, U801.12 (+)
unnamed: RV622.2, U801.9 (-)
SnareFull: R830.1
SnareTrig: D801.2 (A)
White: NT802.1

Notes on the sheet:
NOISE TYPE- 10k
TONE 10k
