hsetlik/ESP808_mk3/(commit log)

2024-04-10 rev. 2 schematic and board
    [Analog.kicad_sch, Clap.kicad_sch, Clave.kicad_sch, Controls.kicad_sch, ESP808_mk3.kicad_sch, HiHats.kicad_sch, IO.kicad_sch, Kicks.kicad_sch]
2024-04-11 Encoder/ expander stuff
2024-04-11 Button and Display stuff
2024-04-13 processor, button interrupt handling
2024-04-14 naming stuff, bit packing stuff
    [Controls.kicad_sch]
2024-04-17 battery monitoring stuff
    [PowerSupply.kicad_sch]
2024-04-17 Display Helpers, frame rate stuff
2024-04-17 framerate label
2024-05-01 Sample logic, PSRAM
    [PowerSupply.kicad_sch]
2024-05-02 Sample playback stuff
2024-05-08 Audio timer/interrupt stuff
2024-05-09 SamplerVoice class
2024-05-10 Sample file stuff
